ms95ir-ctrl/Abadi_Rover/abadi-rover-2/README.md

# Abadi Rover 2: the telepresence robot

A small round robot with a screen and a camera. You stay in Germany, open a link on your phone, talk to your sister through the robot, and drive it around her home. Your sister can also call you with one big button.

**Status: first design draft (5 November 2026). Nothing is built and nothing is tested yet.** Every number comes from files, web sources or calculation. Each document marks what is VERIFIED (seen in a source) and what is ASSUMED (my guess, to be tested).

This folder is separate from **Abadi Rover 1** (the tracked robot with the Raspberry Pi 5, files at the top of the repository: `plan.md`, `wiring.md`, `HANDOVER.md`). Robot 1 is still in progress and nothing here changes it. Both robots use the same motherboard from `../pcb/kicad/` (version v5, the locked pin table is `../pcb/kicad/pin-table.md`).

---

## The robot in one picture

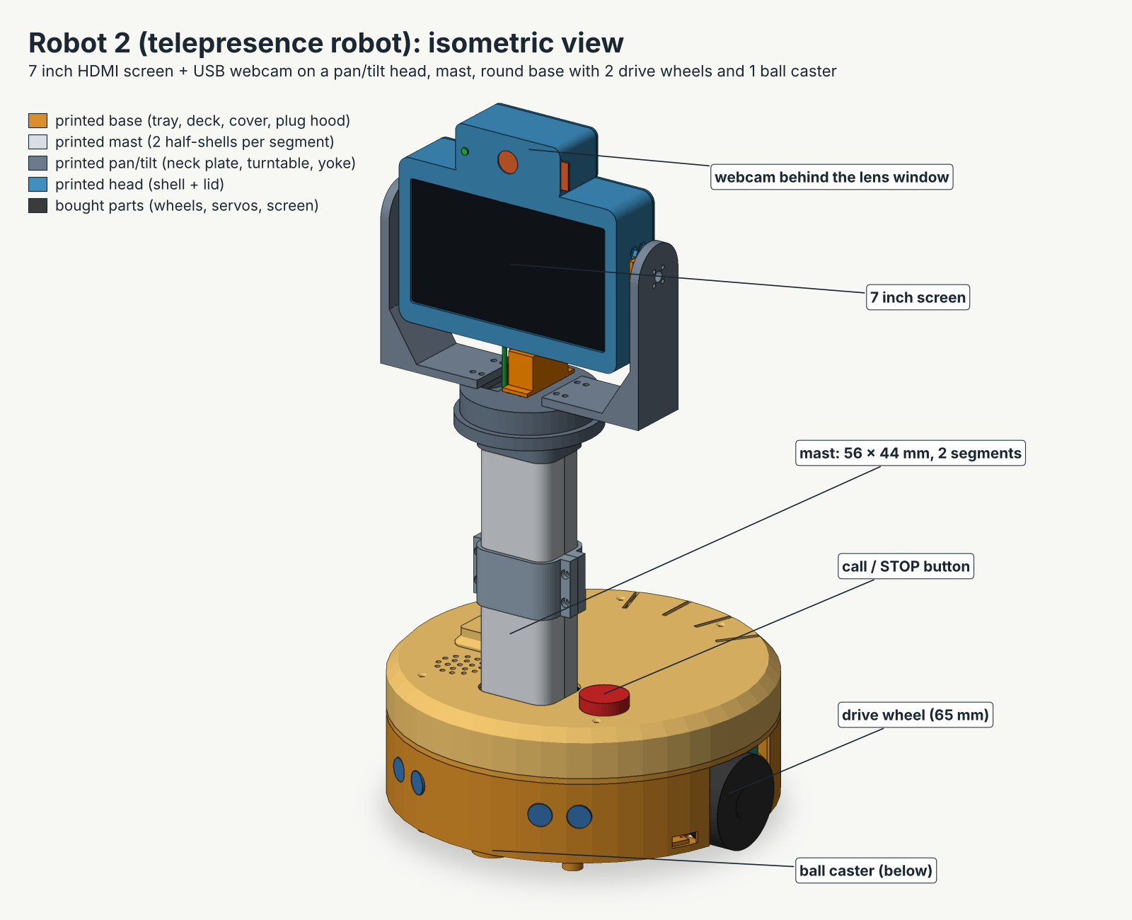
[picture p1: abadi-rover-2/3d/renders/robot2-iso.png]
Robot 2, isometric view


- **Body:** a round printed base, 260 mm wide, with two 65 mm drive wheels and one ball caster. A 214 mm mast carries the head. Total height 504 mm. Weight about 2.6 kg by the CAD (cheap build, first estimate); the parts list adds up to about 2.8 kg because it weighs every pack and cable in full.
- **Head:** a 7 inch HDMI screen with the webcam above it, on a pan and tilt fork (two MG996R servos).
- **Brain, two parts:** a **Raspberry Pi 5** does the video call and the internet link; the **ESP32 on the motherboard** drives the motors, servos and sensors and stops everything if the Pi stops talking. The Pi and the ESP32 talk over one USB cable.
- **Power:** the 2S Li-ion pack, BMS, charger and fused branches as in `../pcb/kicad/power-wiring.png`. A second XL4016 module set to 5.1 V feeds the Pi and the screen.

Wiring diagram: `diagrams/wiring-robot2.png`.

---

## Documents (read in this order)

| File | What it answers |
|---|---|
| `docs/functions.md` | **What can the robot do?** The function list, in plain words. |
| `docs/wiring.md` | **How is it wired?** The final wiring table, the decisions, the power-up order. |
| `diagrams/wiring-robot2.png` / `.svg` | The wiring diagram (source: `diagrams/draw_wiring.py`). |
| `diagrams/battery-4cell.png` / `.svg` | The optional 4-cell battery wiring (2S2P). The 2-cell battery diagram is `../pcb/kicad/battery-wiring.png`. |
| `docs/parts-list.md` and `docs/parts-list.csv` | **What do I buy, and what does it cost?** Two builds (cheap and comfortable), what to buy in Germany before the trip, weights, luggage rules. |
| `docs/sbc-selection.md` | **Which small computer?** Raspberry Pi 5 recommended; why the Radxa Cubie A7S and Orange Pi Zero 2W are not recommended. |
| `docs/mechanical-design.md` + `3d/` | **The body:** base, mast, head, pan/tilt interface, weights, tip-over test, print list. OpenSCAD files (`3d/*.scad`), print-ready STL files (`3d/stl/`), pictures (`3d/renders/`). |
| `docs/peripherals.md` | **Screen, camera, sound, sensors, battery monitor.** Includes the camera test for your SC-012-SN259 and the echo test. |
| `docs/software-plan.md` | **What has to be coded, and in which order.** Video call, remote access, family screen, Wi-Fi in a new place, ESP32 firmware plan, 10 build stages with pass tests, risks. |
| `docs/esp32-serial-protocol.md` | **The USB language between the Pi and the ESP32** (commands, messages, fault codes, stopping rules). |
| `docs/review-log.md` | What the independent review found, what was changed, and the points that are still open. |
| `docs/00-brief.md` | The brief the helper agents worked from (your request and the fixed facts). |

---

## The decisions so far

| Question | Decision | Where |
|---|---|---|
| Which small computer? | **Raspberry Pi 5, 2 GB** (or the Pi 5 8 GB you already own, if robot 1 can wait). Cheapest that really works: Pi 4 2 GB. **Not** the Radxa Cubie A7S (no HDMI port, immature software) or the Orange Pi Zero 2W. | `docs/sbc-selection.md` |
| Video call, first version | **Public Jitsi Meet in the robot's browser**, joining a one-time room. You are always the host. Version 2: one own web page. | `docs/software-plan.md`, section 3 |
| Reaching the robot from Germany | **Tailscale** (free private link; no router change at your sister's home). | section 4 |
| What stops the robot if the link drops | Four independent timers (250 ms, 300 ms, 500 ms, 1000 ms); it stops in about 0.4 s, or about 0.6 s if the ESP32 program hangs (both ASSUMED until measured). | section 4 and the protocol file |
| Chassis | A **new printed two-wheel base**, not the ELEGOO tracks (robot 1 needs those). | `docs/mechanical-design.md` |
| Motors | **Pololu 25D 12 V gearmotor, 47:1, two.** The yellow TT motors are too weak. | same |
| Screen | 7 inch HDMI touch screen (Waveshare (C) about 58 EUR, or a no-name one about 45 EUR). | `docs/peripherals.md` |
| Camera | Test your **SC-012-SN259** first (it could not be found online). Fallback: a cheap wide-angle 1080p webcam, about 22 EUR. | same |
| Pan/tilt | My default (two MG996R servos in a fork), **with a swappable plate** (INTERFACE 1) for your own design. | `docs/mechanical-design.md`, section 7 |
| Money | Cheap build about **582 EUR** if everything is bought new (417 EUR with spares from your drawer; 366 EUR if robot 1 lends parts). Comfortable build about **821 EUR** (614 / 487 EUR). The totals leave out a bench power supply (borrow one if you can) and the optional parts. | `docs/parts-list.md` |

---

## Build order (one stage at a time, one pass test each)

The software plan has the full pass tests. **Before the trip** these must be finished: stages 1 to 5, 7 and 9, **plus the safety part of stage 8** (stair-edge sensors, tilt and pick-up detection, family STOP). Stage 6 (pan and tilt) is strongly recommended. Rule: remote driving stays switched off in the software until the stair-edge and tilt tests pass. The first drives at your sister's home are with her standing next to the robot, away from stairs.

0. **Today, before any stage:** order the Pololu motors (they can take 2 to 3 weeks from the USA) and the screen; check that the boards you ordered are version v5; do the 10 minute camera test. Start printing the base parts (about 43 hours for the whole first build) only after you have checked every size marked (A) with the real parts (button, speaker, servo plugs, LED, webcam: `docs/mechanical-design.md`, section 11, step 1). Print `head_shell`, the lid, the yoke and the turntable only after the real screen, webcam and servos have arrived and been measured (make a paper template of the screen first). The mechanical assembly (`docs/mechanical-design.md`, section 11) and the first power-up (`docs/wiring.md`, section 4) run together: power-up steps 1 and 2 come before the deck goes on; steps 3 to 6 belong to stages 3 to 6 and are done with the cover still off (assembly step 7). Close the cover (assembly step 9) only after stages 3 to 5 and the servo check (power-up step 5) have passed.
1. Bench call: Pi, screen, webcam and audio only. Measures whether the Pi copes with the call.
2. The robot service: idle screen, call button, auto-start.
3. Power: the Pi and screen on the robot's own supply.
4. ESP32 link over USB (with the two cable bench tests), battery monitor, low-battery warning and clean shutdown, no motors yet.
5. Drive (wheels in the air first). Stop-time tests. The service dead-man timer and tab-close handling are built here.
6. Pan and tilt.
7. Remote access from the internet, on mobile data.
8. Safety sensors: sonar, stair edges, tilt and pick-up (the stair-edge and tilt part is required before the trip).
9. Polish and field kit: new-Wi-Fi rehearsal, spare SD card, family card.
10. Version 2: one page with video and controls.

Rule: no code for a later stage until the current stage passed on the real hardware. **No application code exists yet**; this folder has only plans, specs, diagrams and 3D files.

---

## What I need from you

1. **Which country** is the trip to, and **how many days** until you leave? (Decides what can be bought there, delivery times, and whether services such as Tailscale and Jitsi are reachable.)
2. **Your 3D printer and its bed size** (the design needs at least 180 x 180 mm). Do you print before the trip and pack the parts?
3. **Your pan/tilt design:** a photo, STL or the numbers in `docs/mechanical-design.md` section 7.4.
4. **The webcam SC-012-SN259:** its size and a photo, or run the 10 minute test in `docs/peripherals.md`.
5. **Can robot 1 lend its Pi 5 8 GB** (and battery parts) for the trip?
6. **Charging while the robot is on:** the current power plan says charge with the robot off. For a robot that can be called, that needs a decision. See `docs/wiring.md`, section 6. My default for now: the family switches the robot on at agreed call times and charges it at night.
7. **2 cells or 4 cells?** Two cells give about 1.1 to 1.4 hours of calling (about 1 hour if the robot also drives). Four cells double that but weigh more and need the 2S2P wiring in `docs/wiring.md`. My default for the first build is 2 cells.
8. **Are the 5 boards you ordered version v5?** All pin numbers here assume v5 (`../pcb/kicad/pin-table.md`).
9. The open questions at the end of each document.

### How to type a command (the documents use this a lot)

A "terminal" is a window where you type one line and press Enter. On the Raspberry Pi: open the menu, choose *Accessories*, then *Terminal* (or press `Ctrl` + `Alt` + `T`). Type the line exactly as written (copy and paste works), then press Enter. `sudo` at the start means "do this as the administrator"; the Pi may ask for your password. `nano` is a small text editor in the terminal: save with `Ctrl` + `O` then Enter, leave with `Ctrl` + `X`. On Windows, "Command Prompt" or "PowerShell" is the same idea; the 3D file commands have a Windows form in `docs/mechanical-design.md`, section 12.

---

## Honest limits of this draft

- No part was built, measured or tested. The weight, tip-over and runtime numbers are calculations.
- No tested 720p Chromium video call was found for any small board, including the Raspberry Pi. The home test in `docs/sbc-selection.md` section 10 decides this.
- Prices come from web search results, not from shop pages (the shops could not be opened). Check the live price when you buy.
- The mass (about 2.6 kg by the CAD for the cheap build, about 3.0 kg for the comfortable build; the parts list adds up to about 2.8 and 3.3 kg) is higher than the 1.5 to 2 kg target of the first draft, and the robot tips with about 4.4 N of push at head height (a ramp of about 22 degrees tips it). A shorter mast, ballast and a software tilt guard are described in `docs/mechanical-design.md`, section 8.
- **Runtime is short.** On 2 cells the robot calls for only about 1.1 to 1.4 hours (about 1 hour if it also drives); 4 cells give about 2.2 to 2.8 hours (all ASSUMED, measured in stage 3). Charging while the robot is on is not decided yet.
- The pan cable path in the head is not proven: until the real cable bundle is tested in stage 6, the pan range is limited to +/-30 degrees in the software.
- The stair-edge sensors see an edge only a few centimetres before the robot is lost, so keep the robot away from stairs; nothing protects driving backwards (`docs/mechanical-design.md`, section 5.6).
- Li-ion cells and power banks go in **carry-on luggage only**.
- The 3D design now has a 30 mm hole for the call / STOP button, a speaker grille on the cover top, a 5 mm camera-light hole and a camera slide-cover slot in the head. Their sizes are ASSUMED (open item C5 in `docs/peripherals.md`): measure your real button, speaker, LED and webcam and compare with `3d/robot2_params.scad` before you print the large parts.
