ms95ir-ctrl/Abadi_Rover/pcb/kicad/reports/kicad-drc-report.txt

** Drc report for /tmp/claude-0/-home-user-Abadi-Rover/2e40e7c1-9ccc-529a-8cb9-c3782861ad82/scratchpad/kb/final6.kicad_pcb **
** Created on 2026-10-20 20:47:07 **

** Found 38 DRC violations **
[lib_footprint_issues]: The current configuration does not include the library 'abadi'.
    Local override; Severity: warning
    @(194.5000 mm, 136.1900 mm): Footprint TM1
[lib_footprint_issues]: The current configuration does not include the library 'abadi'.
    Local override; Severity: warning
    @(196.0000 mm, 146.0000 mm): Footprint H2
[lib_footprint_issues]: The current configuration does not include the library 'abadi'.
    Local override; Severity: warning
    @(105.5000 mm, 76.5000 mm): Footprint TL3
[lib_footprint_issues]: The current configuration does not include the library 'abadi'.
    Local override; Severity: warning
    @(177.7500 mm, 135.0000 mm): Footprint C1
[lib_footprint_issues]: The current configuration does not include the library 'abadi'.
    Local override; Severity: warning
    @(145.6200 mm, 89.0000 mm): Footprint RLY2H
[lib_footprint_issues]: The current configuration does not include the library 'abadi'.
    Local override; Severity: warning
    @(187.0000 mm, 141.7700 mm): Footprint C3
[lib_footprint_issues]: The current configuration does not include the library 'abadi'.
    Local override; Severity: warning
    @(173.2000 mm, 54.2000 mm): Footprint SPARE
[lib_footprint_issues]: The current configuration does not include the library 'abadi'.
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
    Local override; Severity: warning
    @(112.3000 mm, 128.9500 mm): Footprint PCA
[lib_footprint_issues]: The current configuration does not include the library 'abadi'.
    Local override; Severity: warning
    @(148.1600 mm, 93.4000 mm): Footprint UART
[lib_footprint_issues]: The current configuration does not include the library 'abadi'.
    Local override; Severity: warning
    @(164.1500 mm, 103.0000 mm): Footprint DRVB
[lib_footprint_issues]: The current configuration does not include the library 'abadi'.
    Local override; Severity: warning
    @(112.4000 mm, 87.1000 mm): Footprint GYRO
[lib_footprint_issues]: The current configuration does not include the library 'abadi'.
    Local override; Severity: warning
    @(166.8600 mm, 89.0000 mm): Footprint SON1
[lib_footprint_issues]: The current configuration does not include the library 'abadi'.
    Local override; Severity: warning
    @(186.5200 mm, 92.5000 mm): Footprint RD2b
[lib_footprint_issues]: The current configuration does not include the library 'abadi'.
    Local override; Severity: warning
    @(137.0000 mm, 54.2000 mm): Footprint SCR_L

** Found 0 unconnected pads **

** Found 0 Footprint errors **

** End of Report **
