ms95ir-ctrl/Abadi_Rover/abadi-rover-2/diagrams/battery-4cell.png

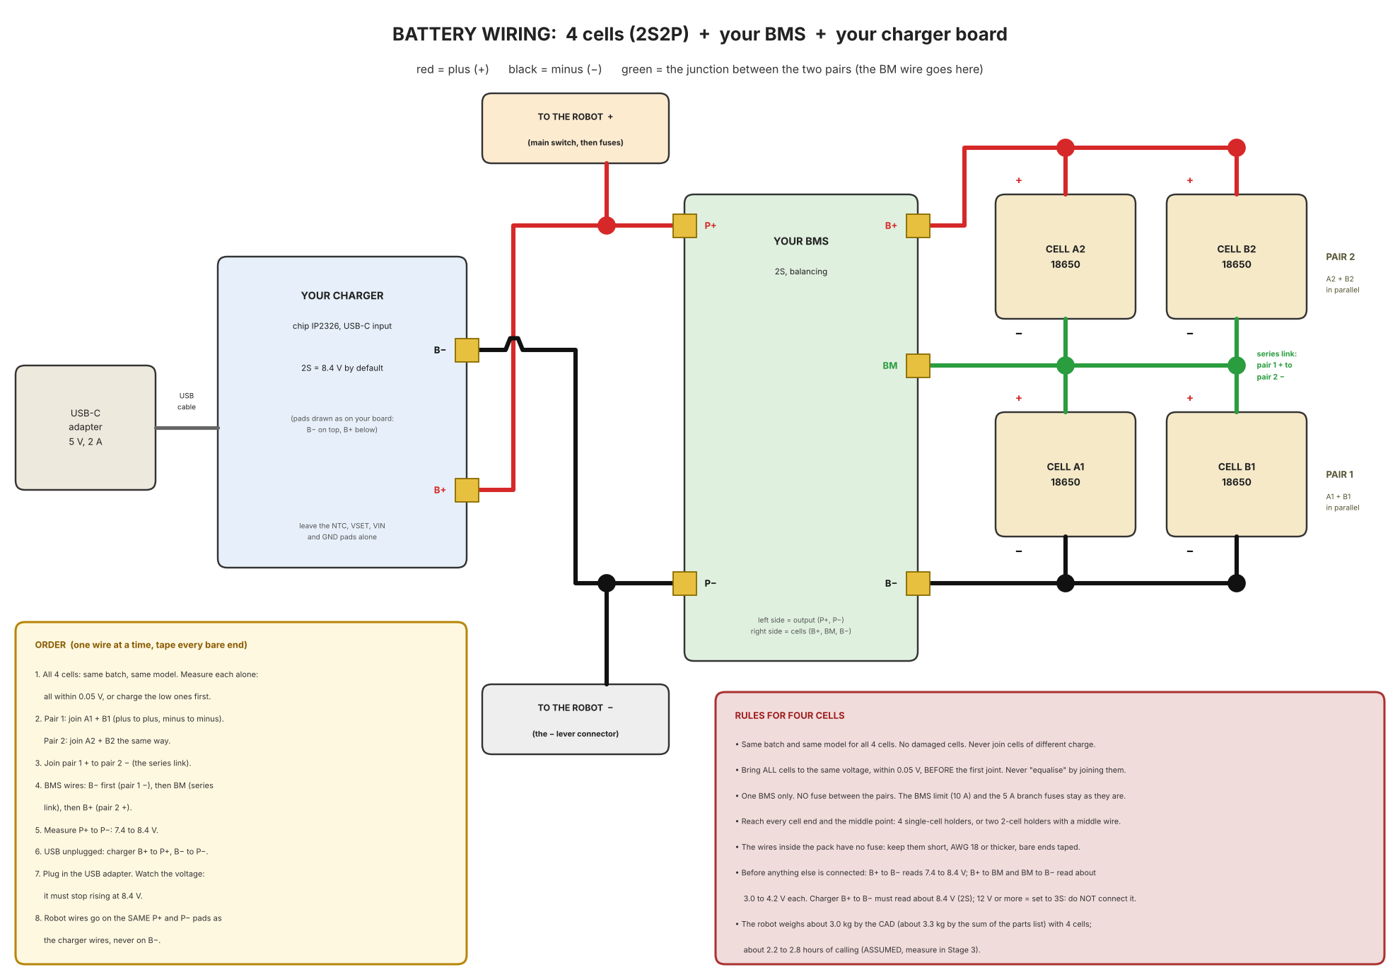
abadi-rover-2/diagrams/battery-4cell.png
