ms95ir-ctrl/Abadi_Rover/pcb/board-draft.png

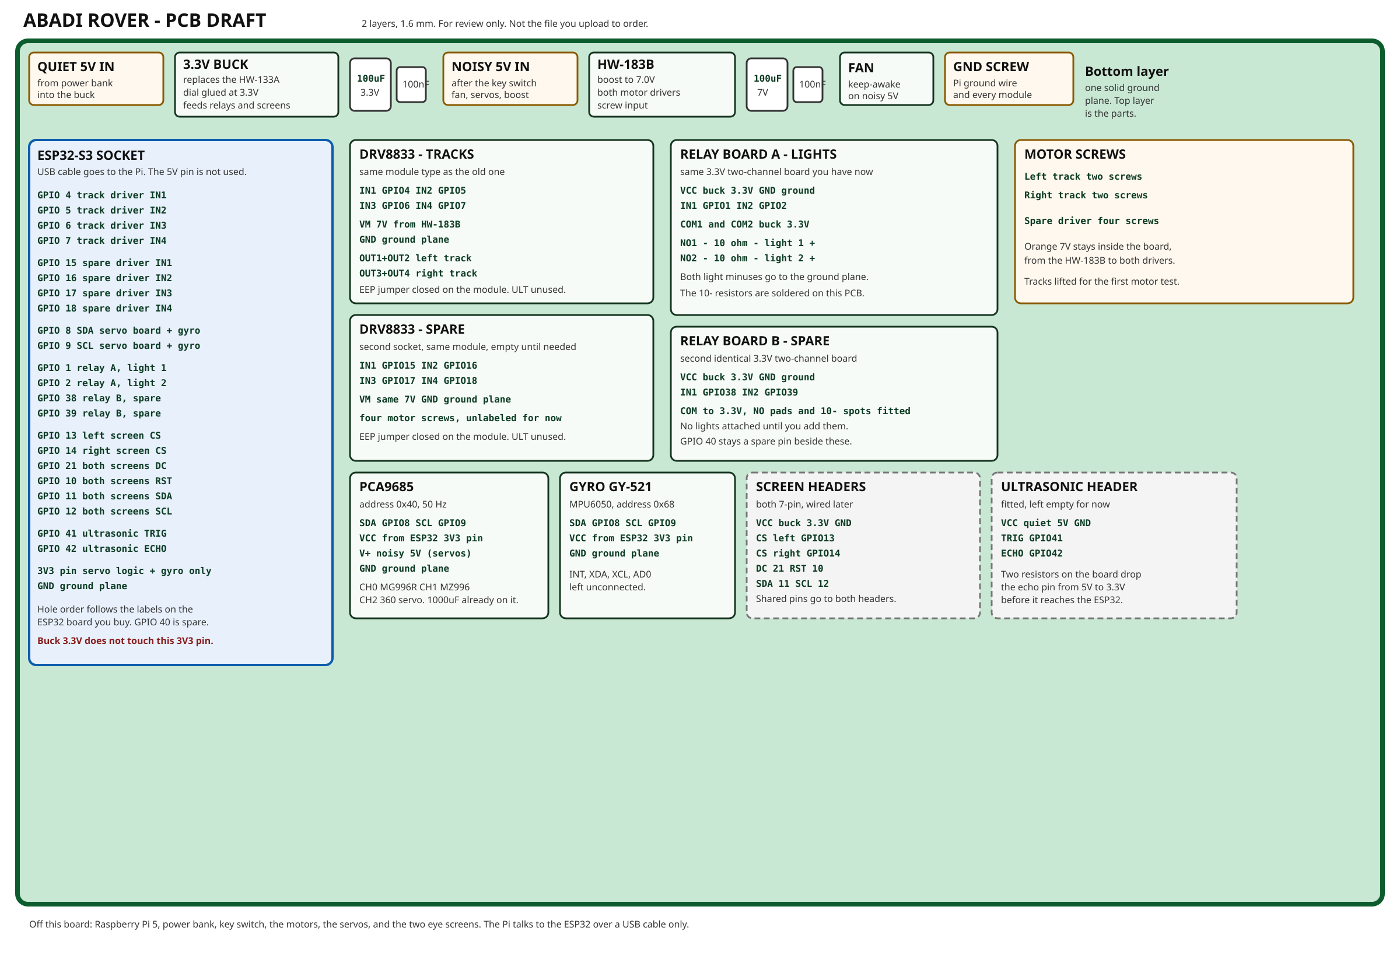
pcb/board-draft.png
