ms95ir-ctrl/Abadi_Rover/pcb/draft/floorplan_v0_3d.png

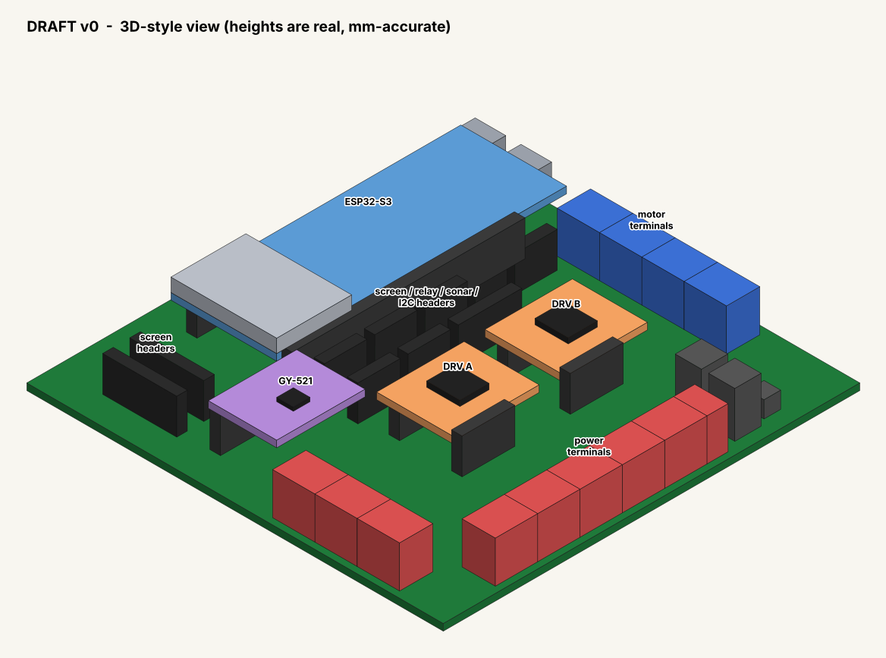
pcb/draft/floorplan_v0_3d.png
