ms95ir-ctrl/Abadi_Rover/pcb/draft/floorplan_v0_top.png

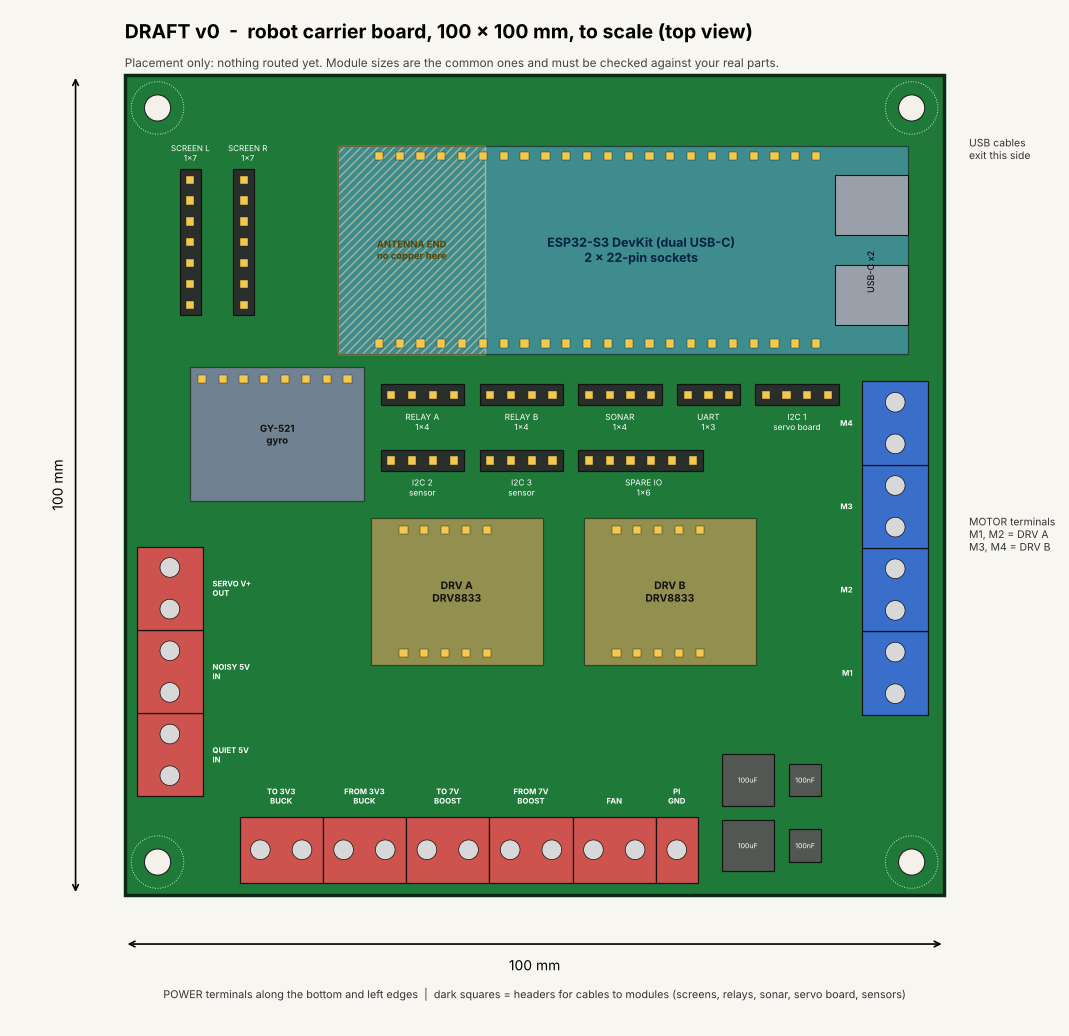
pcb/draft/floorplan_v0_top.png
