ms95ir-ctrl/Abadi_Rover/pcb/draft/floorplan_v1_top.png

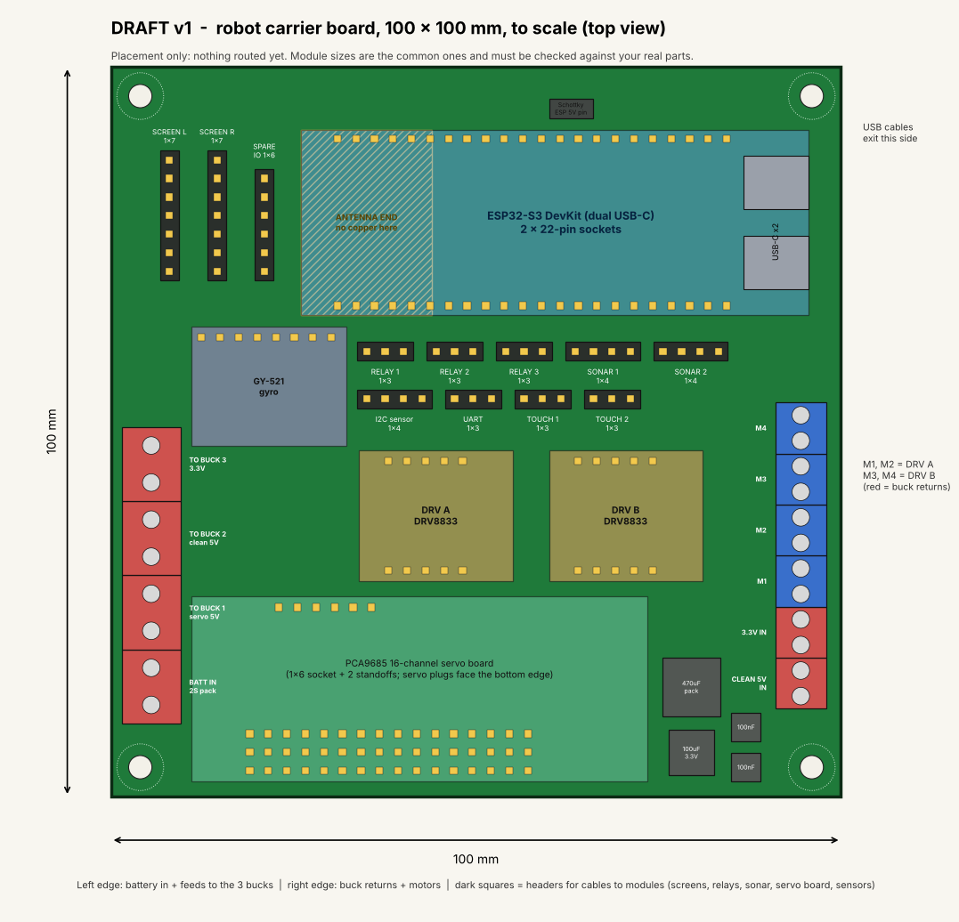
pcb/draft/floorplan_v1_top.png
