ms95ir-ctrl/Abadi_Rover/pcb/gerber-preview.png

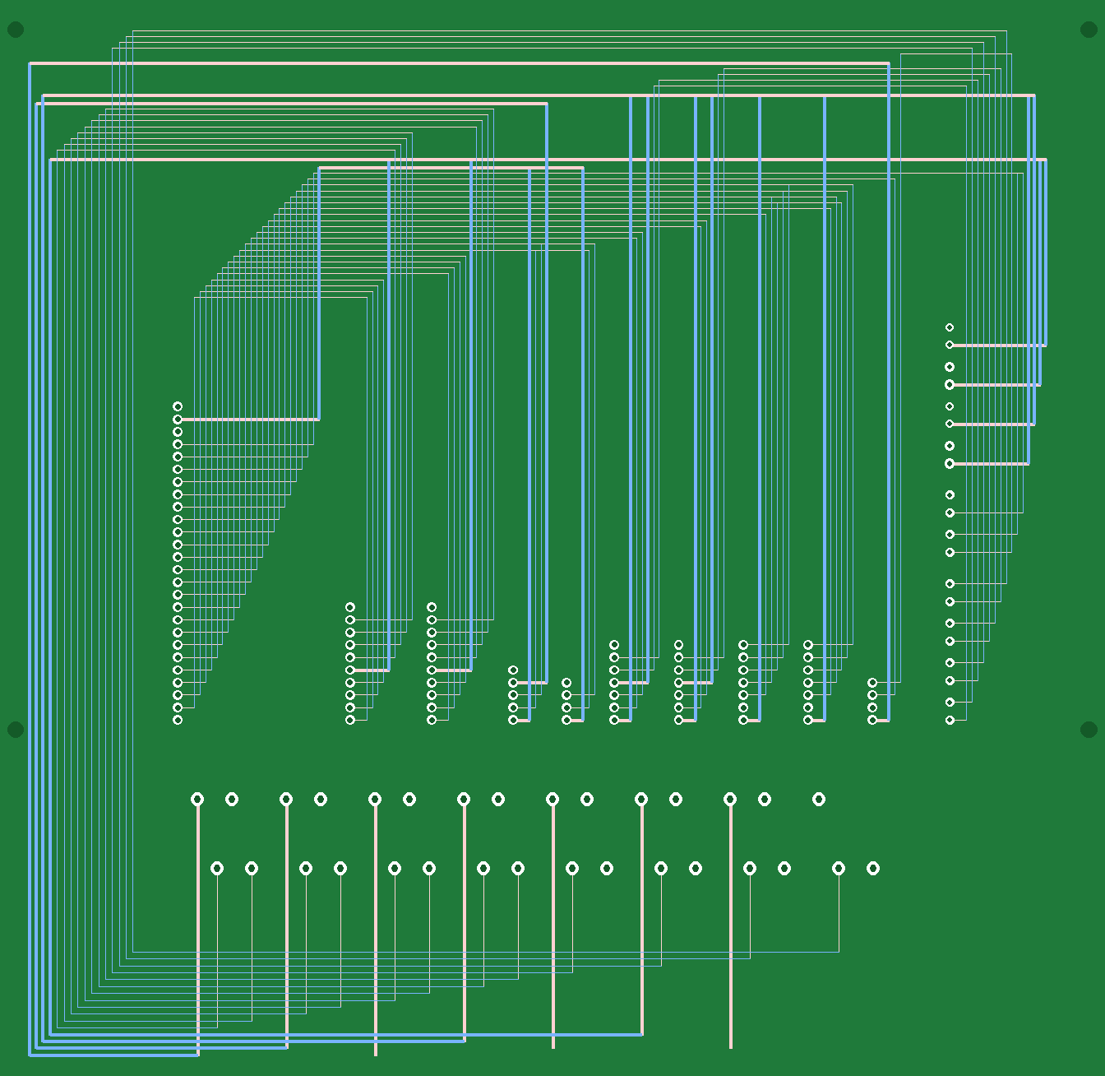
pcb/gerber-preview.png
