ms95ir-ctrl/Abadi_Rover/pcb/kicad/board-copper.png

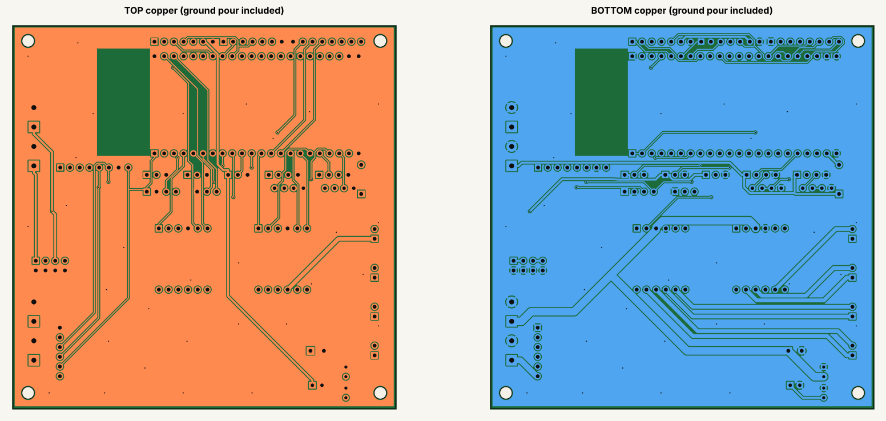
pcb/kicad/board-copper.png
