ms95ir-ctrl/Abadi_Rover/pcb/kicad/board-top.png

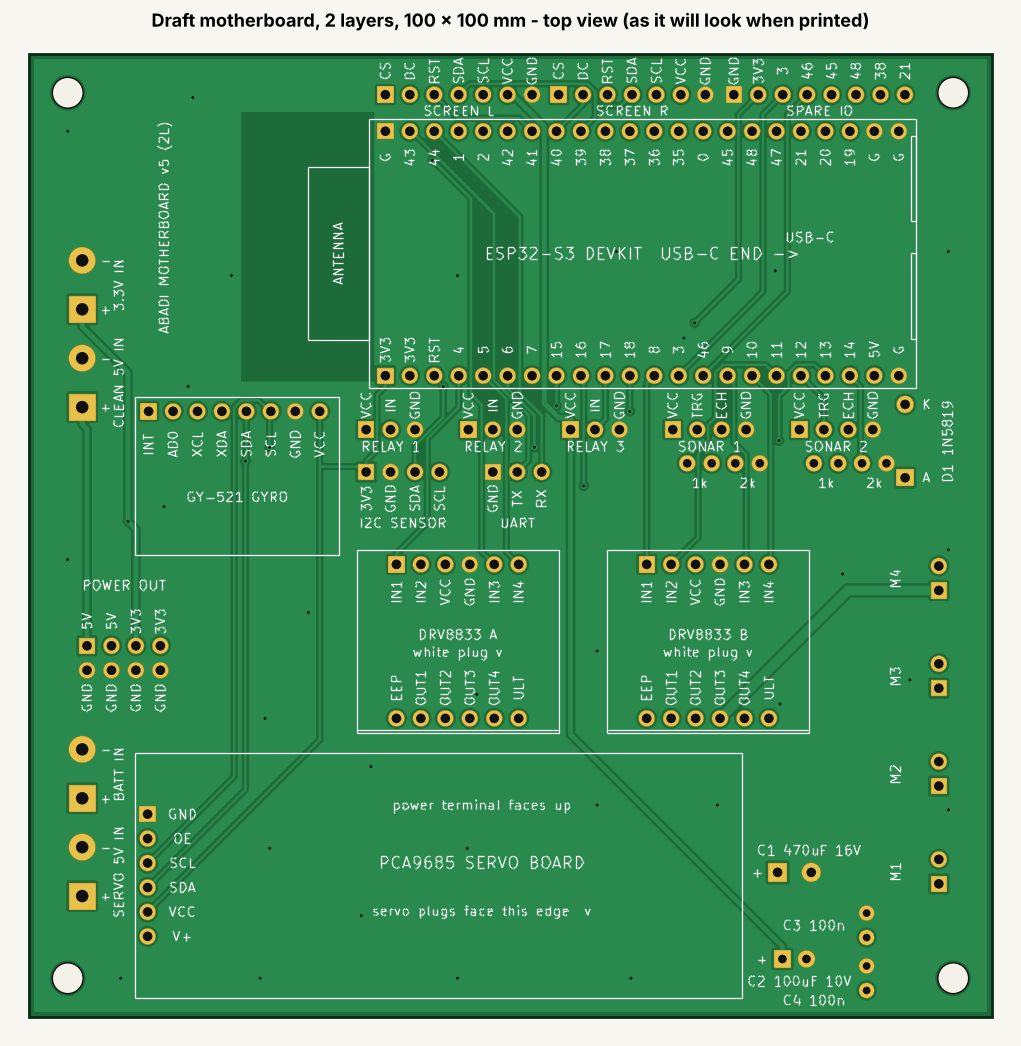
pcb/kicad/board-top.png
