ms95ir-ctrl/Abadi_Rover/pcb/layout.png

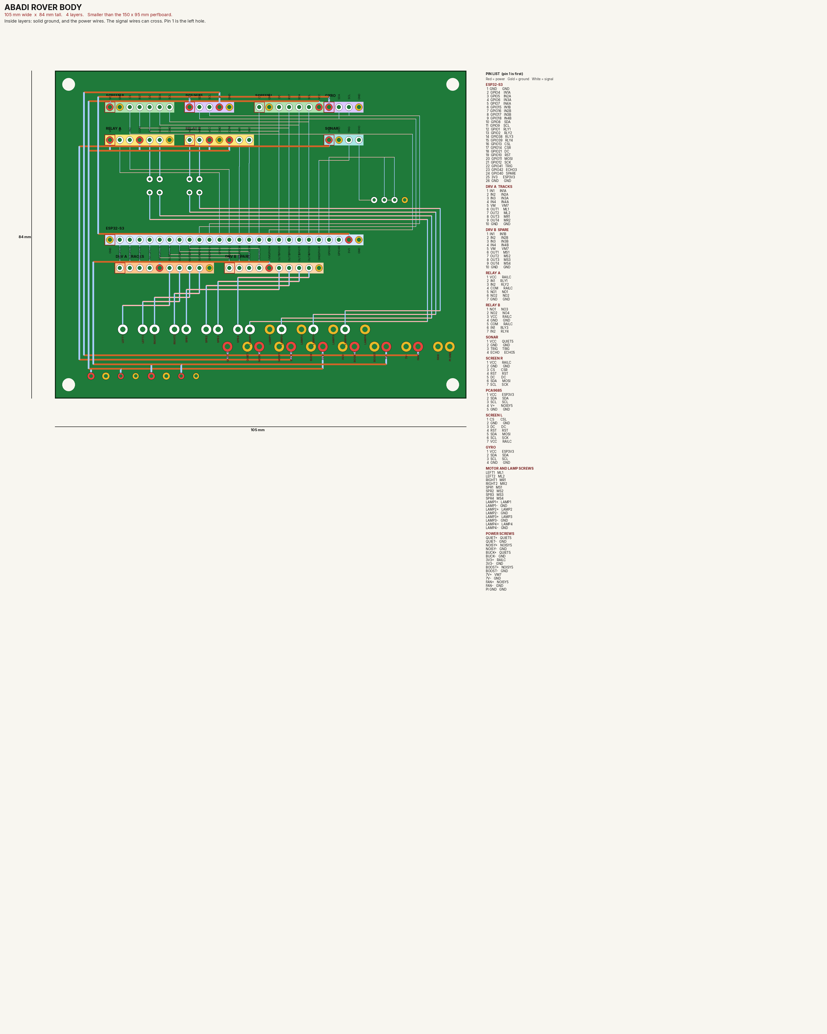
pcb/layout.png
