ms95ir-ctrl/Abadi_Rover/abadi-rover-2/3d/tools/parts.txt

tray_FL
tray_FR
tray_RL
tray_RR
deck_FL
deck_FR
deck_RL
deck_RR
cover_FL
cover_FR
cover_RL
cover_RR
caster_cup
caster_ring
motor_cap
skid
plug_hood
bumper_R
bumper_C
bumper_L
mast_lo_front
mast_lo_back
mast_up_front
mast_up_back
collar_front
collar_back
foot_plate
neck_plate
turntable
yoke_servo_side
yoke_plain_side
head_shell
head_lid
pivot_bush
cam_cover
