ms95ir-ctrl/Abadi_Rover/abadi-rover-2/docs/parts-list.csv

group | item | quantity | unit_price_eur | total_eur | build | already_owned_maybe | buy_where | buy_before_trip | weight_g | on_robot | notes
1 Brain and screen | Raspberry Pi 4 Model B, 2 GB (the cheapest board that really works) | 1 | 72.00 | 72.00 | cheap | no | Berrybase, Reichelt, Welectron | DE | 46 | yes | About 71.90 EUR on 1 Oct 2026 (Notebookcheck). Runs near full load in a 720p call, so the first call is asked at 480p. Fan and performance mode needed (sbc-selection.md, section 3).
1 Brain and screen | Raspberry Pi 5, 2 GB (recommended board) | 1 | 82.50 | 82.50 | comfort | maybe-robot1 | Berrybase, Reichelt, Welectron | DE | 46 | yes | About 82.50 EUR (Notebookcheck, 1 Oct 2026). 4 GB costs about 115-150 EUR. Free option: take your own Pi 5 8 GB if robot 1 can wait.
1 Brain and screen | Raspberry Pi 5 Active Cooler (official) | 1 | 5.90 | 5.90 | comfort | no | Welectron (5.90 EUR incl. VAT, art. RP9-111480) | DE | 12 | yes | Pi 5 only. Fits under the cover (cooler 13.7 mm high).
1 Brain and screen | Heatsink plus small 5 V fan for the Pi 4 | 1 | 6.00 | 6.00 | cheap | maybe-robot1 | Amazon.de, Berrybase | DE | 20 | yes | You own a 5 V fan for robot 1; robot 2 needs its own. About price (ASSUMED).
1 Brain and screen | microSD card 32 GB, A1 or A2, SanDisk or Samsung (main card) | 1 | 9.00 | 9.00 | both | no | any shop | any | 1 | yes | About price (ASSUMED). Buy a known brand, not an unnamed one.
1 Brain and screen | microSD card 32 GB (clone = spare card) | 1 | 9.00 | 9.00 | both | no | any shop | any | 1 | no | Clone the finished card onto it (stage 9; the spare card is a pass test there). Packed in the luggage, not in the robot.
1 Brain and screen | 7 inch HDMI screen, 1024x600 IPS, touch: no-name type | 1 | 45.00 | 45.00 | cheap | no | eBay.de, Amazon.de | DE | 250 | yes | Listings 43-57 EUR (eBay.de search). Check outline about 165x100-107 mm, full-size HDMI, 5 V micro-USB. Weight varies.
1 Brain and screen | Waveshare 7 inch HDMI LCD (C), 1024x600 IPS, 5-point touch (recommended screen) | 1 | 58.00 | 58.00 | comfort | no | exp-tech.de, Eckstein, Welectron, elecena.pl, melopero.com | DE | 250 | yes | Seen 48-62 EUR incl. VAT depending on shop (exp-tech.de 44.95 EUR is without VAT, about 53.50 with VAT; search summaries, re-check the shop page). 164.9x107x8 mm, 5 V 500 mA (Waveshare wiki). Stock varies: order early.
1 Brain and screen | HDMI cable, micro-HDMI to HDMI-A, flat and slim, 0.8 m | 1 | 12.00 | 12.00 | both | no | Amazon.de, Reichelt | DE | 40 | yes | Needs about 0.65 m (mast route); sbc-selection.md now says the same. Right-angle plug at the screen end is better.
1 Brain and screen | Screen power lead: micro-USB plug with bare wires, power only | 1 | 3.00 | 3.00 | both | maybe-spare | any (cut an old micro-USB cable) | any | 15 | yes | Wires go to the 5.1 V SBC buck branch (not to the clean 5 V). Via the 1 A fuse.
1 Brain and screen | USB-C plug breakout board with solder pads, for the SBC power pigtail (you solder your own AWG 18-20 silicone wire to ALL the VBUS and GND pads) | 1 | 5.00 | 5.00 | both | no | Amazon.de, eBay.de | DE | 20 | yes | Or cut a thick 5 A USB-C cable and read the wire gauge printed on its jacket. If the wire is thinner than AWG 20, use a 3 A fuse on this branch (the fuse assortment in group 4 should have one: check the listing) and accept a Pi 5 peak limit; with a Pi 4 get thicker wire instead (sbc-selection.md, section 7, points 4 and 5). Short: under 40 cm. The wire is the silicone wire line in group 4. About price (ASSUMED).
1 Brain and screen | Capacitor 1000 uF, 16 V, low-ESR (at the SBC power input) | 1 | 0.60 | 0.60 | both | maybe-spare | Reichelt | any | 4 | yes | Across 5.1 V and GND at the Pi end. 470 uF also fine.
1 Brain and screen | USB-A to USB-C cable, short (20 cm), ordinary (has the 5 V wire), for the ESP32 COM socket | 1 | 4.00 | 4.00 | both | maybe-spare | any | any | 10 | yes | Plug it into the data-only adapter below. It is also the one spare ordinary cable: if bench test B fails (the two bench tests are written out in peripherals.md, 6.1), use it on its own. Taping the 5 V contact (pin 1 of the USB-A plug) is a backup only.
1 Brain and screen | USB data-only adapter (power blocker, no 5 V wire), for the ESP32 link and for touch | 2 | 5.00 | 10.00 | both | no | Amazon.de (search: USB power blocker / Stromsperre) | DE | 20 | yes | One for the ESP32 link, one for the touch cable. Not the same as a 'data blocker' (that blocks data). Check the ESP32 one with bench test A (the devkit's LED stays dark, peripherals.md, 6.1) and the touch one with the screen-dark check (peripherals.md, 2.2). About price (ASSUMED).
1 Brain and screen | Touch cable, micro-USB to USB-A, thin, about 1 m, data (the screen box may already contain one: check that it reaches the SBC through the mast, about 0.65 m plus slack) | 1 | 3.00 | 3.00 | both | maybe-spare | any (or the one from the screen box) | any | 15 | yes | It goes into the second data-only adapter. Keep it uncut: the screen power lead is a separate cable. About price (ASSUMED).
1 Brain and screen | USB-A right-angle adapter (90 degrees, male plug to female socket), for the webcam, the ESP32 link, the touch cable and the sound adapter or speakerphone | 4 | 2.50 | 10.00 | both | no | Amazon.de, eBay.de | DE | 24 | yes | The USB ports face the rear wall and only 20 to 42 mm of room is left (mechanical-design.md, 5.2), so straight plugs and the data-only adapters would press on the wall. Dry-fit with the real parts before you print the base. If the webcam gets the extension cable below, its adapter is a spare. About price (ASSUMED).
1 Brain and screen | USB-A extension cable, about 1 m, male right-angle plug to female socket (for a webcam whose cable is fixed to the camera) | 1 | 4.00 | 4.00 | both | no | Amazon.de, eBay.de | DE | 30 | yes | mechanical-design.md, 6.2: the camera's own plug joins it inside the head. Needed if the camera cable cannot be unplugged (most cannot). About price (ASSUMED).
2 Camera and audio | Webcam: your own SC-012-SN259, if it passes the test | 1 | 0.00 | 0.00 | cheap | maybe-robot1 | from robot 1 (phase 3 has not started) | DE | 60 | yes | Model not found on the web: size, view angle and microphone are ASSUMED. Test first (peripherals.md). Buy another for robot 1 later.
2 Camera and audio | Wide-angle USB webcam, 1080p, UVC, with microphone (fallback or comfort) | 1 | 22.00 | 22.00 | comfort | no | Amazon.de | DE | 70 | yes | About 15-30 EUR (ASSUMED). Check body fits the brow 60x30x28 mm and view angle 90-110 degrees.
2 Camera and audio | USB audio adapter (3.5 mm speaker out) | 1 | 7.00 | 7.00 | cheap | no | Amazon.de, eBay.de | any | 10 | yes | Cheap audio route B. Not needed with route A (speakerphone).
2 Camera and audio | Speaker 40 mm, 4 ohm, 3 W | 1 | 2.50 | 2.50 | cheap | no | Reichelt, eBay.de | any | 15 | yes | Goes in the cover top, right of the mast, facing up; not in the head lid (echo). The CAD has the grille and the pocket (mechanical-design.md, 7.1); the 15 mm depth is ASSUMED, measure yours.
2 Camera and audio | PAM8403 amplifier board, 5 V | 1 | 2.50 | 2.50 | cheap | no | eBay.de, AZ-Delivery | any | 3 | yes | Powered from the 5.1 V Pi-buck output through its OWN 1 A fuse (6th fuse holder, group 4), not through the screen fuse. Input from the USB audio adapter through the audio cable below.
2 Camera and audio | Audio cable, 3.5 mm plug to bare wires (or a cut aux cable), for the amplifier input | 1 | 1.50 | 1.50 | cheap | maybe-spare | any (cut an old aux cable) | any | 15 | yes | Route B only. Two wires (signal and ground) go to the amplifier input; the plug goes into the green socket of the USB audio adapter.
2 Camera and audio | USB speakerphone with real echo cancelling (Jabra Speak 410 class) | 1 | 75.00 | 75.00 | comfort | no | Amazon.de, Galaxus.de, eBay.de | DE | 350 | yes | Seen 60-85 EUR (eBay new 59.99, a shop 84.99 in Jun 2026). Cheaper ones (17-31 EUR) do not say 'echo cancellation': do not trust them. Weight and size ASSUMED. Doubles as ballast. The CAD has a flat spot of 115 mm diameter on the cover top, behind the mast (mechanical-design.md, 7.1).
2 Camera and audio | LEDs 5 mm red, 5 pieces, plus 220 ohm resistors | 1 | 2.00 | 2.00 | both | maybe-spare | Reichelt, any | any | 2 | yes | Plain red LEDs that light at 3.3 V. Camera-live LED on PCA9685 channel 2 (and button light on channel 3). If every PCA9685 output already has a 220 ohm resistor (small SMD parts marked 221), connect the LED with NO extra resistor and check the brightness.
2 Camera and audio | USB clip-on microphone (only if the webcam has no microphone) | 1 | 8.00 | 8.00 | opt | no | Amazon.de | any | 15 | yes | Only needed if the webcam test finds no microphone and you use route B.
3 Sensing | HC-SR04 ultrasonic sensor, 5 V type (not the 3.3 V HC-SR04P) | 2 | 2.00 | 4.00 | both | maybe-robot1 | AZ-Delivery, Berrybase, eBay.de | DE | 18 | yes | The board's 1k/2k divider expects a 5 V echo.
3 Sensing | HC-SR04 spare | 1 | 2.00 | 2.00 | comfort | no | AZ-Delivery, Berrybase, eBay.de | DE | 9 | no | Spare.
3 Sensing | IR floor sensor module, TCRT5000 type, digital output, 3.3-5 V (cliff) | 2 | 1.50 | 3.00 | both | no | eBay.de, Amazon.de | DE | 8 | yes | About 31x14 mm per mechanical doc (ASSUMED). Must work at 12 mm from the floor.
3 Sensing | IR floor sensor spares, to find a pair that reads your floor | 2 | 1.50 | 3.00 | both | no | eBay.de, Amazon.de | DE | 8 | no | Dark carpet can fool IR sensors. Buy 4 modules in both builds, test them on your floors and keep the best two (peripherals.md, 5.2): the cliff sensors are part of the required safety stage.
3 Sensing | ADS1115 16-bit analog-to-digital board (battery monitor) | 1 | 4.50 | 4.50 | both | no | eBay.de, AZ-Delivery, Reichelt | DE | 3 | yes | 3.5-5 EUR on eBay.de, up to about 13 EUR in local shops (software-plan listing check).
3 Sensing | ADS1115 spare | 1 | 4.50 | 4.50 | comfort | no | eBay.de, AZ-Delivery, Reichelt | DE | 3 | no | Spare.
3 Sensing | Resistor and capacitor kit: 47k x2, 27k x2 (1 %), 10k x4, 100 nF x4 | 1 | 5.00 | 5.00 | both | maybe-spare | Reichelt, any | any | 5 | yes | Battery divider 47k/27k + 100 nF (the 47k sits on the splice-plus wire, the 27k and 100 nF at the ADS1115). Charger sense 2 x 10k (optional). A 10k is also the bump-switch pull-down (optional).
3 Sensing | Call / STOP button, arcade type 30 mm (optionally with a 3.3 V LED ring) | 1 | 3.50 | 3.50 | both | no | Amazon.de, Reichelt | DE | 20 | yes | GPIO45 to GND. A physical STOP / call button is a Must before the trip (functions.md, rows 9 and 12), so it is in both builds. The CAD has a 30 mm hole on the cover top, left of the mast (mechanical-design.md, 7.1; size ASSUMED, measure your button). A button light must work at 3.3 V: not a 12 V arcade ring.
3 Sensing | Micro switch with lever (KW12-3 type), 2 pieces, bumper | 1 | 2.00 | 2.00 | opt | no | Amazon.de, eBay.de | any | 4 | yes | Optional, not in the first build. If fitted: switches between GPIO46 and 3V3, plus a 10k pull-DOWN from GPIO46 to GND (peripherals.md, 5.4). The protocol lists GPIO46 as 'optional bump input' (event ev btn id:bump).
4 Power | 18650 Li-ion cell, genuine Samsung 25R / LG MJ1 / Molicel P28A class | 2 | 6.00 | 12.00 | both | maybe-spare | Akkuman, Akkuteile.de, Nkon | DE | 92 | yes | Seen 3.99-10 EUR per cell. You own old cells: test them first and use a matched pair (same voltage within 0.05 V before joining). Carry-on only.
4 Power | 18650 cells, 2 more (the 4-cell option, 2S2P: double runtime) | 2 | 6.00 | 12.00 | comfort | maybe-spare | Akkuman, Akkuteile.de, Nkon | DE | 92 | yes | All four cells from the same batch and the same model, brought to the same voltage within 0.05 V before joining. Build 2P, then 2S, one BMS only: see wiring.md, section 'Four-cell option (2S2P)' and diagrams/battery-4cell.png. Needs a bigger battery cradle in the base (about 77 x 80 x 21 mm). The robot then weighs about 3.3 kg by the sum of this list (3.03 kg by the CAD).
4 Power | Battery holder for 2 x 18650 | 1 | 2.00 | 2.00 | both | no | Amazon.de, Reichelt | any | 14 | yes | 77x40x21 mm per mechanical doc. The BMS needs a wire at the point between the two cells (BM): use a 2-cell holder where you can reach that point, or two single-cell holders. 4-cell option: four single-cell holders in total, or two 2-cell holders whose middle point you can reach and join (next line).
4 Power | Battery holder, 2nd set for the 4-cell option (four single-cell holders in total, or two 2-cell holders whose middle point you can reach and join) | 1 | 2.00 | 2.00 | comfort | no | Amazon.de, Reichelt | any | 14 | yes | This line is one more 2-cell holder or two more single-cell holders (about 2 EUR either way, ASSUMED). A 2-cell holder that is wired in series inside has no middle wire and cannot make the pairs: check this when it arrives, and if there is no middle wire or tag, use single-cell holders. How to join them (2P, then 2S): wiring.md, section 7 'Four-cell option (2S2P)' and diagrams/battery-4cell.png.
4 Power | 2S BMS (HX-2S-JH20 type), balancing | 1 | 3.00 | 3.00 | both | maybe-robot1 | Amazon.de, eBay.de | DE | 8 | yes | Buy twice if robot 1 keeps its own. One BMS only, also with 4 cells.
4 Power | 2S USB-C charger board (IP2326 type, 5 V in, 8.4 V out) | 1 | 5.00 | 5.00 | both | maybe-robot1 | Amazon.de, eBay.de | DE | 6 | yes | Charge with the robot off (shopping list and wiring.md). See conflict C3 in peripherals.md.
4 Power | USB-C wall charger 5 V, at least 2 A (for the charger board) | 1 | 9.00 | 9.00 | both | maybe-spare | any (plug type of the destination) | any | 60 | no | Buy it where you stay if the plug differs.
4 Power | USB-A to USB-C charging cable, 1 m | 1 | 4.00 | 4.00 | both | maybe-spare | any | any | 25 | no
4 Power | Main switch, round rocker, 10 A or more, 19 mm hole | 1 | 2.50 | 2.50 | both | maybe-robot1 | Amazon.de, Reichelt | any | 10 | yes | You own a key switch for robot 1. This one is for the rear wall.
4 Power | In-line fuse holder for 5 x 20 mm fuses | 5 | 1.20 | 6.00 | both | no | Reichelt, Amazon.de | DE | 40 | yes | Five branches: BATT IN, servo buck, clean 5 V buck, SBC buck, screen. The 3.3 V buck is not used in robot 2.
4 Power | In-line fuse holder for 5 x 20 mm fuses, 6th holder (route B: own 1 A fuse for the speaker amplifier) | 1 | 1.20 | 1.20 | cheap | no | Reichelt, Amazon.de | DE | 8 | yes | Route B (cheap build) only. The amplifier gets its own tap from the 5.1 V Pi-buck output through its own 1 A fuse; the screen keeps its own 1 A fuse. With the speakerphone (route A) there is no amplifier and five holders are enough. The 1 A fuse comes from the assortment below.
4 Power | Slow-blow fuses 5 x 20 mm, assortment (1 A, 2 A, 3 A, 5 A) | 1 | 5.00 | 5.00 | both | no | Reichelt, Amazon.de | DE | 5 | yes | Needs: 5 A x3 (BATT IN, servo buck, Pi buck), 2 A x1 (clean 5 V buck), 1 A x2 (screen, and the amplifier in route B), plus spares. The 3 A is only for a Pi 5 with a pigtail wire thinner than AWG 20 (it replaces the 5 A on the Pi branch); with a Pi 4 get thicker wire (AWG 20 or thicker) and keep the 5 A. Check that the assortment you buy lists 3 A; if it does not, buy one single 3 A slow-blow only if you have a Pi 5 and your wire turns out to be thin. The optional 6.3 A slow-blow for the Pi branch is the next line.
4 Power | Slow-blow fuse 5 x 20 mm, 6.3 A (spare for the Pi branch, only if the 5 A fuse blows in rare peaks) | 2 | 0.30 | 0.60 | opt | no | Reichelt, Amazon.de | DE | 2 | no | Optional, not in the totals. Use it only with AWG 18 to 20 wire (peripherals.md, 6.2). About price (ASSUMED).
4 Power | Lever connector Wago 221-415 (5-way) | 4 | 1.20 | 4.80 | both | no | Berrybase, Reichelt, Hornbach | any | 36 | yes | Splice plus and splice minus: two connectors per side, each pair joined by a 10 cm jumper wire in a free slot of each. The plus side has 6 wires, the minus side up to 7. Budget 1.20 EUR each (ASSUMED): 2-way pieces were seen at 0.39 to 0.55 EUR, no 5-way price was seen.
4 Power | XL4016 buck module with heatsink (servo 5.0 V, and SBC 5.1 V) | 2 | 6.00 | 12.00 | both | maybe-robot1 | eBay.de 3-5 EUR, Amazon.de or AZ-Delivery 8-11 EUR | DE | 110 | yes | Two are needed. You own one for robot 1: buy two new. After setting each one with a multimeter, lock the adjust screw with a drop of glue or nail varnish.
4 Power | Fixed 5 V buck, 1.8 A (clean 5 V) | 1 | 2.50 | 2.50 | both | maybe-robot1 | eBay.de, Amazon.de | DE | 3 | yes | Input range must cover 6-8.4 V. After any luggage trip, re-measure all three buck outputs with nothing connected before you plug in the Pi or the ESP32.
4 Power | Silicone wire 1.0 mm2 (AWG 18), red and black, 3 m each | 1 | 7.00 | 7.00 | both | maybe-spare | Amazon.de, Reichelt | any | 40 | yes | Battery, buck and SBC branches, the 10 cm jumpers between the lever connectors, and the second servo feed to the PCA9685 screw terminal. Weight = what is used.
4 Power | Wire 0.5 mm2 and thinner, several colours | 1 | 8.00 | 8.00 | both | maybe-spare | Amazon.de, Reichelt | any | 20 | yes | Sensors, LED, screen power.
4 Power | JST-XH plug kit 2/3/4-pin with crimped wires | 1 | 9.00 | 9.00 | both | maybe-spare | Amazon.de | any | 15 | yes | Board headers are JST-XH / 2.54 mm. You said your plugs fit.
4 Power | Wire end ferrules, assortment | 1 | 5.00 | 5.00 | comfort | no | Amazon.de | any | 0 | no | For the screw terminals and lever connectors.
4 Power | Servo extension cable 50 cm, 3-wire | 3 | 2.00 | 6.00 | both | no | Amazon.de, eBay.de | DE | 36 | yes | Pan, tilt, and the camera LED up the mast. For the LED use a 3-pin plug with the red (V+) wire cut off or taped.
4 Power | Spade lugs (flat crimp terminals), 6.3 mm, small assortment, for the main switch | 1 | 3.00 | 3.00 | both | maybe-spare | Amazon.de, Reichelt | any | 2 | yes | The main switch has spade tabs (wiring.md, peripherals.md section 7). Check the tab width of your switch: 6.3 mm is common (ASSUMED). About price (ASSUMED).
4 Power | Single-cell 18650 charger (TP4056 type) | 1 | 3.00 | 3.00 | comfort | maybe-spare | Amazon.de, eBay.de | any | 25 | no | 4-cell option only: to bring the lower cells up to the same voltage (within 0.05 V) before they are joined (wiring.md, section 7, Four-cell option). Also handy for old cells. About price (ASSUMED).
4 Power | TVS diode SMBJ5.0A (optional protection across the Pi supply wires) | 1 | 0.50 | 0.50 | opt | no | Reichelt, eBay.de | any | 1 | no | Optional, not in the totals.
4 Power | 8.4 V 2 A charger adapter with DC jack (idea for charging while on) | 1 | 10.00 | 10.00 | opt | no | Amazon.de | DE | 120 | no | Only if the power design decides to charge while the robot runs. Not decided: conflict C3.
5 Drive | Pololu 25D metal gearmotor 12 V, medium power, 47:1 (item 3229) | 2 | 36.00 | 72.00 | both | no | Pololu.com, or an EU reseller (Eckstein, Botland) | DE | 182 | yes | Pololu US$29.95 each (search summary only, re-check the page). Plus shipping, 19 % VAT, maybe a courier fee: about 30-45 EUR each delivered (ASSUMED). 2-3 weeks. When they arrive, measure the winding resistance with a multimeter: about 6.7 ohm is expected (12 V / 1.8 A). If it reads well below 5 ohm, do not fit them to the DRV8833 (peripherals.md, section 8).
5 Drive | Robot wheels 65 mm, rubber tyre, hub for 4 mm D-shaft (pair) | 1 | 10.00 | 10.00 | both | no | Amazon.de, eBay.de, robot shops | DE | 60 | yes | Bore is ASSUMED to fit the Pololu 4 mm D-shaft: check before buying.
5 Drive | Hub adapters 4 mm D-shaft for wheels (only if the wheel bore does not fit) | 1 | 8.00 | 8.00 | comfort | no | Pololu, Amazon.de | DE | 20 | yes | Insurance.
5 Drive | Steel ball 16 mm (or 5/8 inch) for the caster | 1 | 1.50 | 1.50 | both | no | hardware store, Amazon.de | any | 17 | yes
5 Drive | Steel ball 16 mm, spare | 1 | 1.50 | 1.50 | comfort | no | hardware store, Amazon.de | any | 17 | no
6 Pan/tilt | MG996R servo, metal gear (pan and tilt) | 2 | 8.00 | 16.00 | both | maybe-robot1 | Amazon.de, eBay.de (4.50-7 EUR), Waveshare 13 EUR | DE | 110 | yes | PCA9685 channel 0 = pan, channel 1 = tilt. Buy twice if robot 1 keeps its servos.
6 Pan/tilt | Aluminium servo horn 25T, 20 mm disc, 4 x M3 holes | 2 | 3.50 | 7.00 | both | no | Amazon.de, AliExpress | DE | 16 | yes | Hard to find locally. The kit's plastic horn is not used.
6 Pan/tilt | MG996R spare | 1 | 8.00 | 8.00 | comfort | no | Amazon.de, eBay.de | DE | 55 | no | Spare.
7 Mechanical hardware | Heat-set insert assortment M2-M5, brass | 1 | 11.00 | 11.00 | both | no | Amazon.de | DE | 15 | yes | Needs 37 x M3 and 8 x M4 (plus 20 % spare). Mechanical doc, section 10.
7 Mechanical hardware | Screw and nut assortment M2.5/M3/M4/M5 hex socket, 6-30 mm | 1 | 16.00 | 16.00 | both | maybe-spare | Amazon.de, Reichelt | any | 70 | yes | Counts in mechanical doc section 10: about 64 x M3, 12 x M4, 4 x M2.5. The 4 motherboard screws are M3 x 6.
7 Mechanical hardware | M5 x 30 bolt with lock nut and 2 washers | 1 | 1.00 | 1.00 | both | maybe-spare | any | any | 10 | yes | Head pivot.
7 Mechanical hardware | PTFE adhesive tape 0.2 mm (turntable glide ring) | 1 | 6.00 | 6.00 | both | no | Amazon.de | DE | 2 | yes | About price (ASSUMED).
7 Mechanical hardware | PETG filament 1 kg spool, 1.75 mm (printed parts weigh about 1.13 kg) | 2 | 13.00 | 26.00 | both | no | Amazon.de, eBay.de | any | 1125 | yes | Seen 9.75-13.45 EUR per kg (deals Jun 2026). Weight = printed parts of the first build without the bumper (3d/tools/results/numbers.txt). Buy the filament first, so that printing can start: it takes about 43 hours (44.6 with the optional bumper), a rough figure (A). No tube needed: the mast is printed.
7 Mechanical hardware | Super glue plus 2-part epoxy | 1 | 6.00 | 6.00 | both | maybe-spare | any | any | 15 | yes | Base seams. The glue also locks the adjust screws of the two XL4016 buck modules once they are set, and a dab of nail varnish or marker pen across each screw and its module makes the position mark (if the line breaks, the screw has turned). No new part to buy.
7 Mechanical hardware | Double-sided foam mounting tape | 1 | 4.00 | 4.00 | both | maybe-spare | any | any | 10 | yes | Modules, screen, webcam.
7 Mechanical hardware | Zip ties 2.5 x 100 mm, 100 pieces | 1 | 3.00 | 3.00 | both | maybe-spare | any | any | 15 | yes | About 25 needed.
7 Mechanical hardware | Self-adhesive cable tie mounts, 10 pieces (2 to 4 needed) | 1 | 2.00 | 2.00 | both | maybe-spare | any | any | 3 | yes | One low in the mast or on the deck, one in the head (mechanical-design.md, 6.3). About price (ASSUMED).
7 Mechanical hardware | Foam pads 3 mm and Kapton tape | 1 | 3.00 | 3.00 | both | maybe-spare | any | any | 5 | yes | Screen retention. The Kapton tape is the backup for the USB 5 V contact (pin 1 of the USB-A plug).
8 Motherboard fit-out | Motherboard v5 bare PCB (5 pieces; order only after the paper test-fit passes, see pcb/kicad/README.md) | 1 | 0.00 | 0.00 | both | maybe-board | JLCPCB (confirm the order status) | DE | 33 | yes | Bare board. You report 5 boards ordered: confirm they are version v5 (pcb/kicad/pin-table.md). If they are not v5, the pin numbers in these files do not apply.
8 Motherboard fit-out | ESP32-S3 DevKitC-1, N16R8, dual USB-C, headers soldered | 1 | 12.00 | 12.00 | both | maybe-board | Amazon.de, AZ-Delivery, AliExpress | DE | 10 | yes | About price (ASSUMED). Check it has two USB-C sockets.
8 Motherboard fit-out | DRV8833 motor driver module HW-627 (driver A only) | 1 | 2.50 | 2.50 | both | maybe-board | Amazon.de, eBay.de | DE | 3 | yes | Robot 2 uses M1 and M2 only, so driver B can stay empty.
8 Motherboard fit-out | DRV8833 HW-627 spare | 1 | 2.50 | 2.50 | comfort | no | Amazon.de, eBay.de | DE | 3 | no | Spare.
8 Motherboard fit-out | PCA9685 16-channel servo driver board | 1 | 6.00 | 6.00 | both | maybe-board | Amazon.de, AZ-Delivery | DE | 12 | yes | Check that it has its own V+ screw terminal: a second AWG 18 feed from the servo buck goes there (peripherals.md, 5.5).
8 Motherboard fit-out | GY-521 gyro board (MPU-6050) | 1 | 3.50 | 3.50 | both | maybe-board | Amazon.de, AZ-Delivery | DE | 3 | yes
8 Motherboard fit-out | Sockets, headers and 5.08 mm screw terminals for the board | 1 | 9.00 | 9.00 | both | maybe-board | Reichelt, AZ-Delivery | DE | 15 | yes | Full list in pcb/kicad/parts-list.md. Robot 2 fits 3 of the 4 terminals (not 3.3V IN).
8 Motherboard fit-out | Capacitors 470 uF and 100 uF, 2 x 100 nF, 1N5819 diode, 4 resistors 1k/2k | 1 | 3.00 | 3.00 | both | maybe-board | Reichelt | any | 5 | yes
9 Tools and consumables | Heat-shrink tubing assortment | 1 | 6.00 | 6.00 | both | maybe-spare | any | any | 3 | yes
9 Tools and consumables | Solder 1 mm, 100 g | 1 | 7.00 | 7.00 | both | maybe-spare | any | any | 100 | no | Tool: you probably own an iron and a multimeter.
9 Tools and consumables | Digital caliper | 1 | 12.00 | 12.00 | comfort | no | Amazon.de | DE | 120 | no | To check servo, webcam and screen sizes before printing. Weight is a guess (A).
9 Tools and consumables | Precision screwdriver and hex key set | 1 | 10.00 | 10.00 | comfort | maybe-spare | any | any | 150 | no | Weight is a guess (A).
9 Tools and consumables | Wire stripper and flush cutter | 1 | 10.00 | 10.00 | comfort | maybe-spare | any | any | 200 | no | Weight is a guess (A).
9 Tools and consumables | USB-C power meter (voltage and current) | 1 | 10.00 | 10.00 | comfort | no | Amazon.de | DE | 25 | no | Handy for the power tests in stage 3, and needed for the fallback of bench test B (peripherals.md, 6.1). Get an in-line meter with a USB-C plug on one side and a USB-C socket on the other (or two sockets and a short USB-C to USB-C cable). It goes between the ordinary cable's USB-C end and the devkit's COM socket, not at the Pi (the Pi's port is USB-A, so it does not fit there). Comfortable build: in the list. Cheap build: not in the total. Do bench test B at home first; only if it fails, buy one (about 10 EUR) or borrow one before the trip. Weight is a guess (A).
9 Tools and consumables | Servo tester | 1 | 3.00 | 3.00 | opt | no | Amazon.de, eBay.de | any | 20 | no | Only for the pan-servo bench test in mechanical-design.md (assembly step 10: power the servo from a tester and check that the turntable turns freely). Optional, not in the totals. About price (ASSUMED).
9 Tools and consumables | Adjustable bench power supply, 0 to 15 V or more, at least 3 A (5 A is better), with a volt display and a current limit | 1 | 40.00 | 40.00 | opt | maybe-spare | borrow one, or Amazon.de | any | 1500 | no | Needed for the tests before the trip: the Pi under load with the pack voltage at 6.4 V and at 6.0 V (wiring.md, step 4) and the low-battery test at 6.7 V and 6.3 V (software-plan.md, Stage 4, pass 9). Borrow one if you can. The price is a guess (ASSUMED): simple adjustable ones with 3 A cost about 25 to 35 EUR, 5 A ones about 40 to 60 EUR. In no total.
10 Travel and spares | Spare ESP32-S3 DevKitC-1 | 1 | 12.00 | 12.00 | comfort | no | Amazon.de, AZ-Delivery | DE | 10 | no
10 Travel and spares | LAN cable 2 m (Wi-Fi plan D) | 1 | 3.00 | 3.00 | both | no | any | any | 60 | no | Stage 9 rehearses Wi-Fi plan D (software-plan.md).
10 Travel and spares | Small USB keyboard (Wi-Fi plan E) | 1 | 10.00 | 10.00 | both | maybe-spare | any | any | 300 | no | Stage 9 tries Wi-Fi plan E once (software-plan.md).
10 Travel and spares | Travel plug adapter | 1 | 8.00 | 8.00 | comfort | no | any | any | 60 | no | Country not known yet.
10 Travel and spares | Spare USB cables (USB-A to USB-C, ordinary, with data and 5 V) | 2 | 4.00 | 8.00 | comfort | maybe-spare | any | any | 20 | no
10 Travel and spares | Laminating pouches for the family card | 1 | 2.00 | 2.00 | both | no | any | any | 5 | no | For the family card (stage 9).
10 Travel and spares | Hard box or organiser for the trip (about 30 x 25 x 20 cm) | 1 | 15.00 | 15.00 | comfort | no | any | any | 400 | no | Printed parts stack into this size.
