ms95ir-ctrl/Abadi_Rover/abadi-rover-2/3d/stl/yoke_plain_side.stl

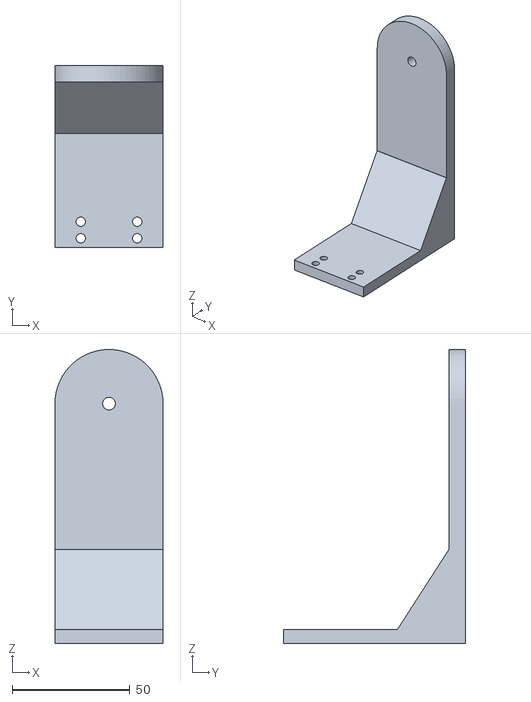
[picture p20: CAD file, 2026-11-05]
abadi-rover-2/3d/stl/yoke_plain_side.stl
46.0 x 77.5 x 125.0
