ms95ir-ctrl/Abadi_Rover/abadi-rover-2/3d/stl/motor_cap.stl

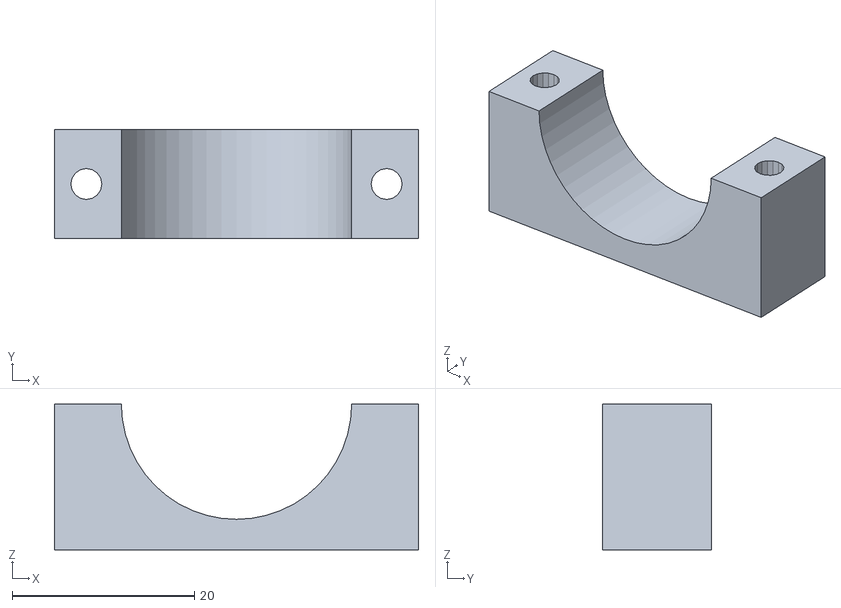
[picture p21: CAD file, 2026-11-05]
abadi-rover-2/3d/stl/motor_cap.stl
40.0 x 12.0 x 16.0
