ms95ir-ctrl/Abadi_Rover/abadi-rover-2/3d/stl/bumper_R.stl

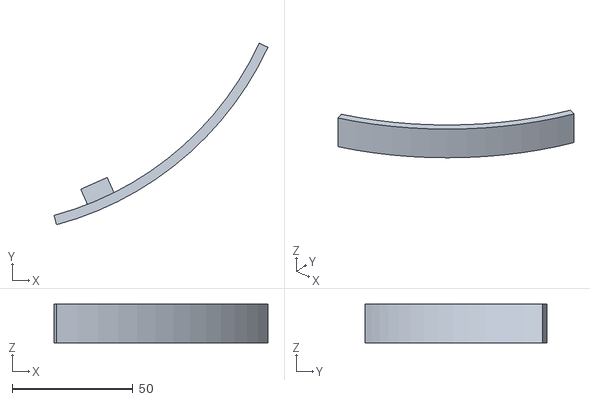
[picture p22: CAD file, 2026-11-05]
abadi-rover-2/3d/stl/bumper_R.stl
88.4 x 75.0 x 16.0
