ms95ir-ctrl/Abadi_Rover/abadi-rover-2/3d/stl/mast_lo_front.stl

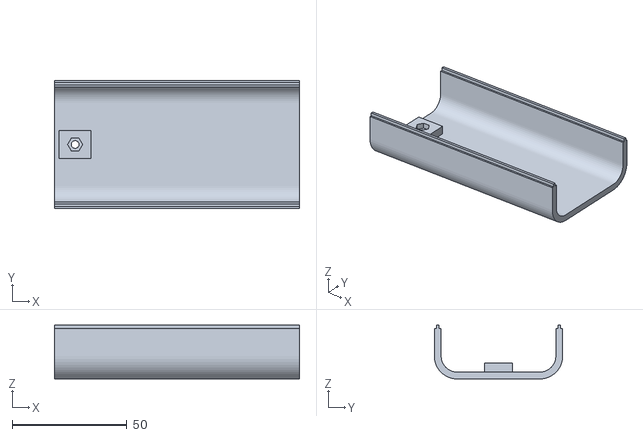
[picture p23: CAD file, 2026-11-05]
abadi-rover-2/3d/stl/mast_lo_front.stl
106.8 x 56.0 x 23.5
