ms95ir-ctrl/Abadi_Rover/abadi-rover-2/3d/stl/tray_RR.stl

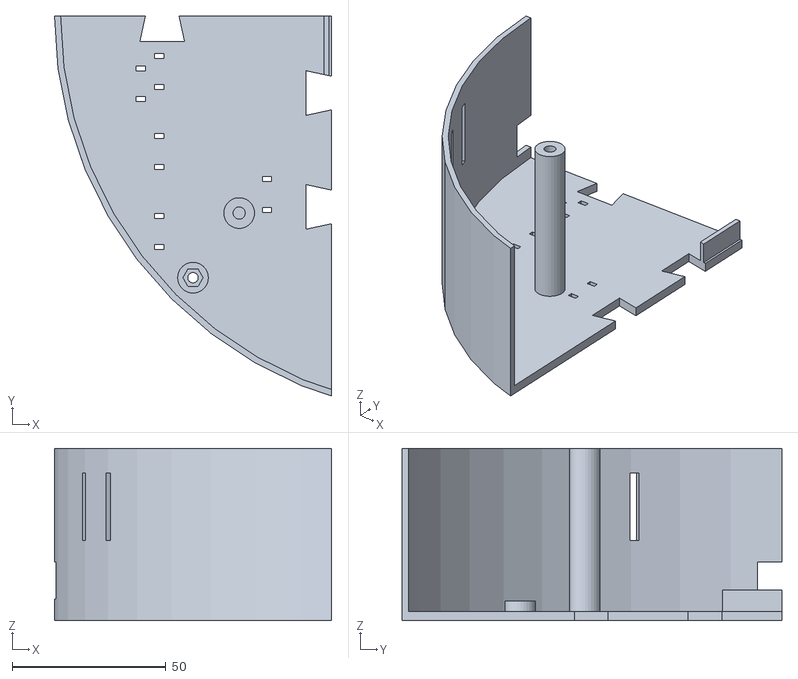
[picture p24: CAD file, 2026-11-05]
abadi-rover-2/3d/stl/tray_RR.stl
90.0 x 123.4 x 56.0
