ms95ir-ctrl/Abadi_Rover/abadi-rover-2/3d/stl/head_lid.stl

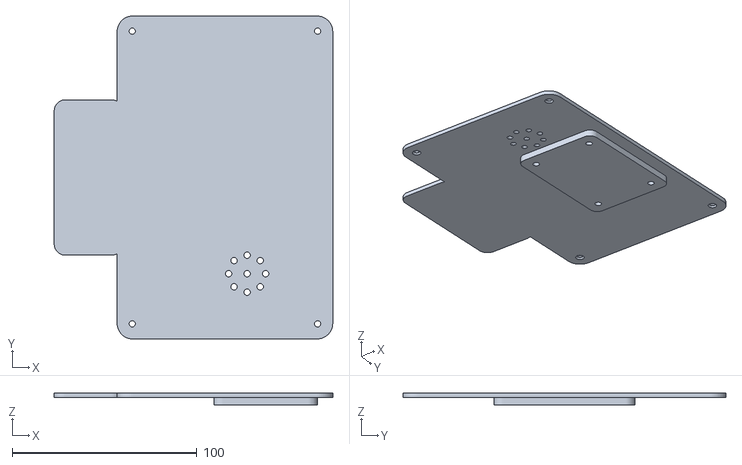
[picture p25: CAD file, 2026-11-05]
abadi-rover-2/3d/stl/head_lid.stl
150.6 x 174.6 x 6.40
