ms95ir-ctrl/Abadi_Rover/abadi-rover-2/3d/stl/mast_up_back.stl

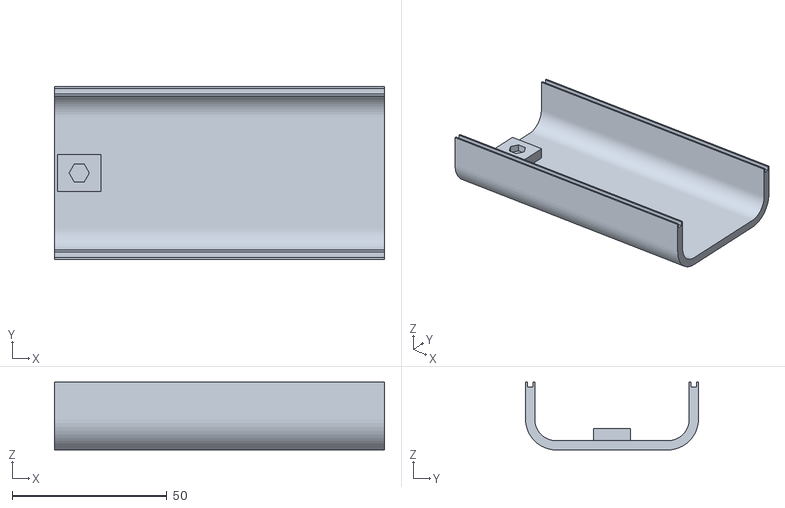
[picture p27: CAD file, 2026-11-05]
abadi-rover-2/3d/stl/mast_up_back.stl
106.8 x 56.0 x 22.0
