ms95ir-ctrl/Abadi_Rover/abadi-rover-2/3d/stl/bumper_C.stl

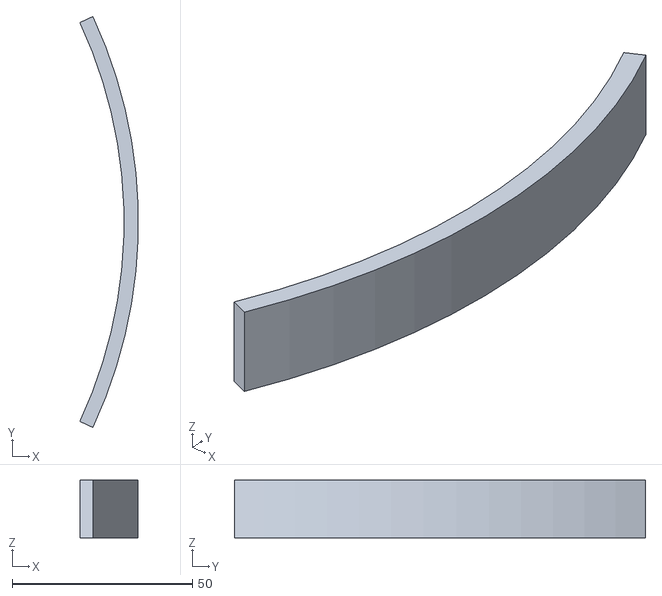
[picture p28: CAD file, 2026-11-05]
abadi-rover-2/3d/stl/bumper_C.stl
16.2 x 114.1 x 16.0
