ms95ir-ctrl/Abadi_Rover/abadi-rover-2/3d/stl/collar_front.stl

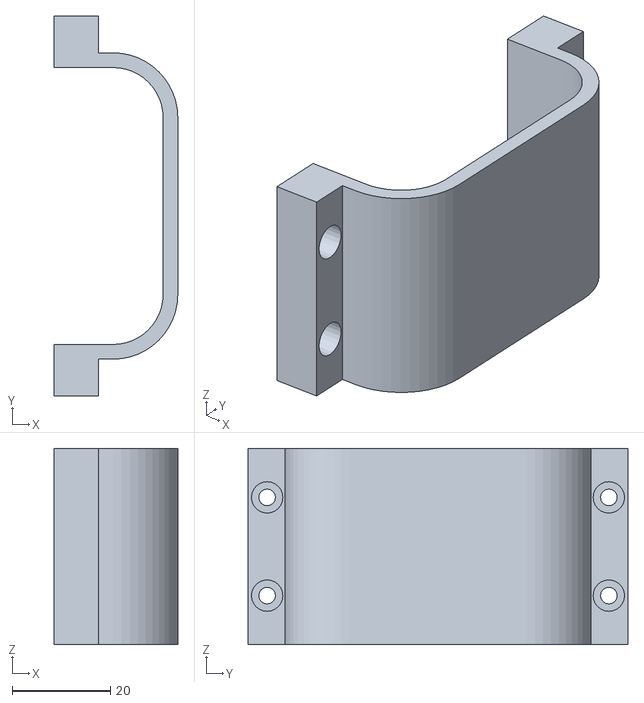
[picture p29: CAD file, 2026-11-05]
abadi-rover-2/3d/stl/collar_front.stl
25.2 x 77.4 x 40.0
