ms95ir-ctrl/Abadi_Rover/abadi-rover-2/3d/stl/caster_cup.stl

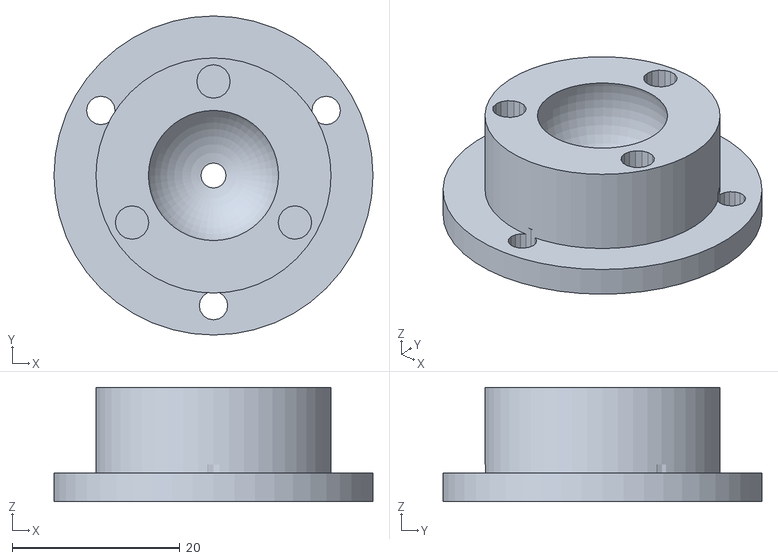
[picture p32: CAD file, 2026-11-05]
abadi-rover-2/3d/stl/caster_cup.stl
38.0 x 38.0 x 13.6
