ms95ir-ctrl/Abadi_Rover/abadi-rover-2/3d/stl/caster_ring.stl

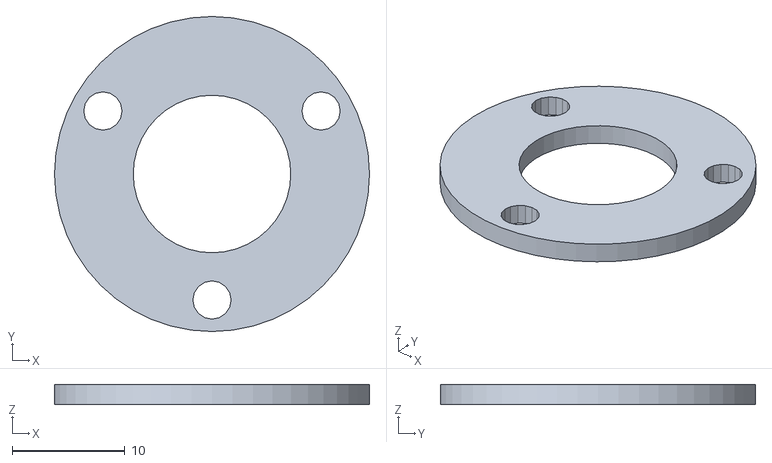
[picture p33: CAD file, 2026-11-05]
abadi-rover-2/3d/stl/caster_ring.stl
28.0 x 28.0 x 1.80
