ms95ir-ctrl/Abadi_Rover/abadi-rover-2/3d/stl/deck_RL.stl

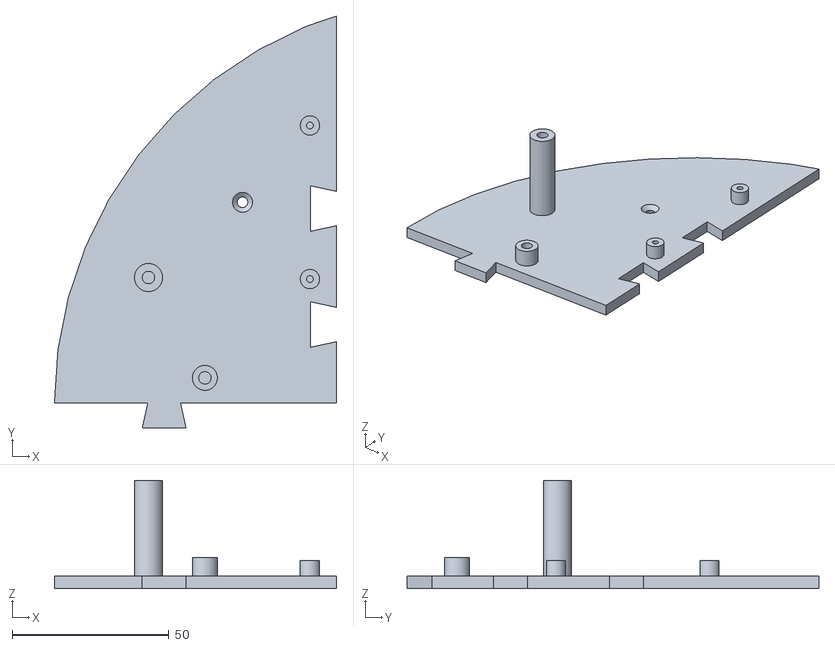
[picture p34: CAD file, 2026-11-05]
abadi-rover-2/3d/stl/deck_RL.stl
90.0 x 131.4 x 34.6
