ms95ir-ctrl/Abadi_Rover/abadi-rover-2/3d/stl/neck_plate.stl

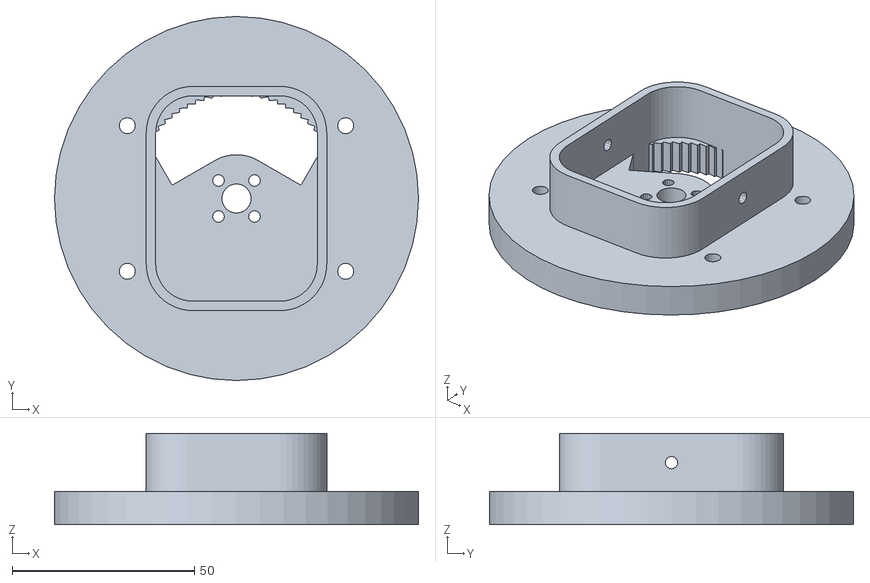
[picture p35: CAD file, 2026-11-05]
abadi-rover-2/3d/stl/neck_plate.stl
100.0 x 100.0 x 25.0
