ms95ir-ctrl/Abadi_Rover/abadi-rover-2/3d/stl/foot_plate.stl

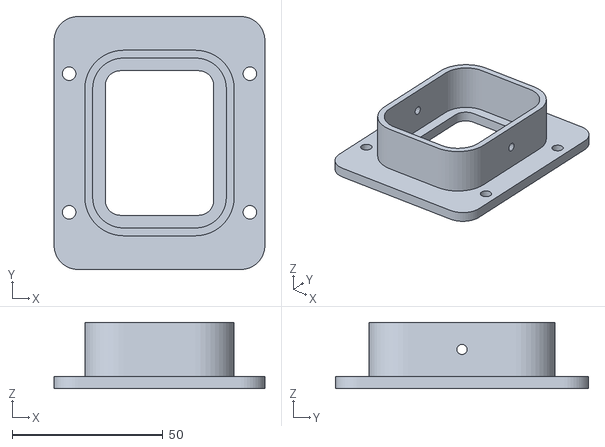
[picture p37: CAD file, 2026-11-05]
abadi-rover-2/3d/stl/foot_plate.stl
70.0 x 84.0 x 22.0
