ms95ir-ctrl/Abadi_Rover/abadi-rover-2/3d/stl/tray_FL.stl

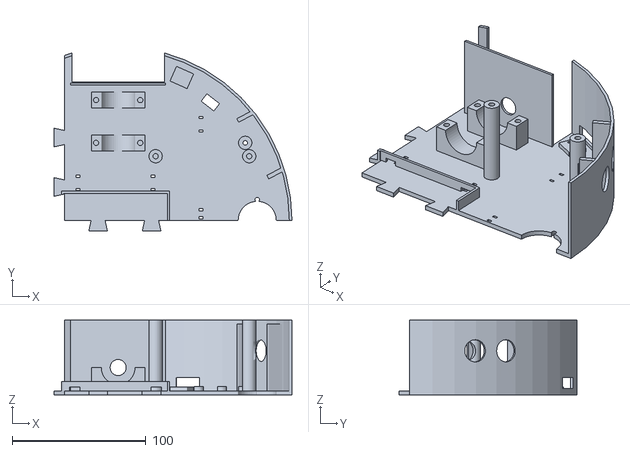
[picture p38: CAD file, 2026-11-05]
abadi-rover-2/3d/stl/tray_FL.stl
178.0 x 133.3 x 56.0
