ms95ir-ctrl/Abadi_Rover/abadi-rover-2/3d/stl/tray_FR.stl

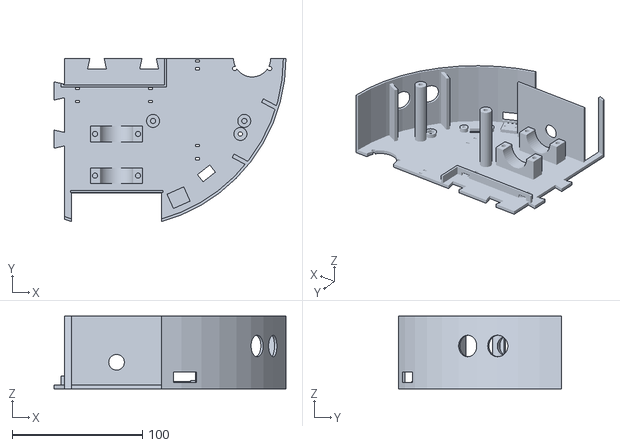
[picture p39: CAD file, 2026-11-05]
abadi-rover-2/3d/stl/tray_FR.stl
178.0 x 125.3 x 56.0
