ms95ir-ctrl/Abadi_Rover/abadi-rover-2/3d/stl/turntable.stl

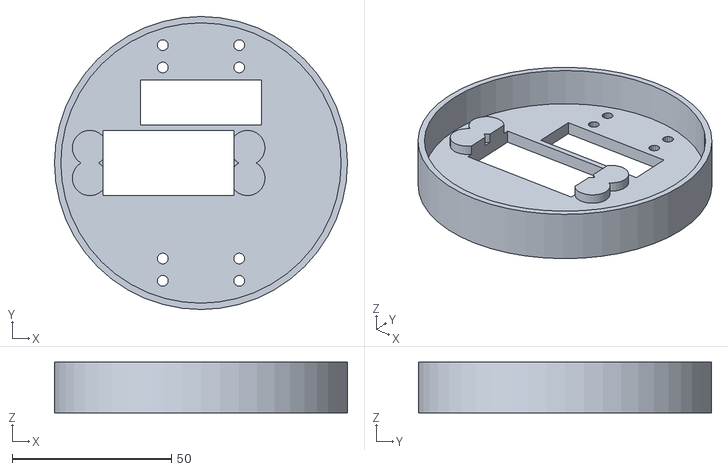
[picture p40: CAD file, 2026-11-05]
abadi-rover-2/3d/stl/turntable.stl
92.0 x 92.0 x 16.0
