ms95ir-ctrl/Abadi_Rover/abadi-rover-2/3d/stl/deck_FR.stl

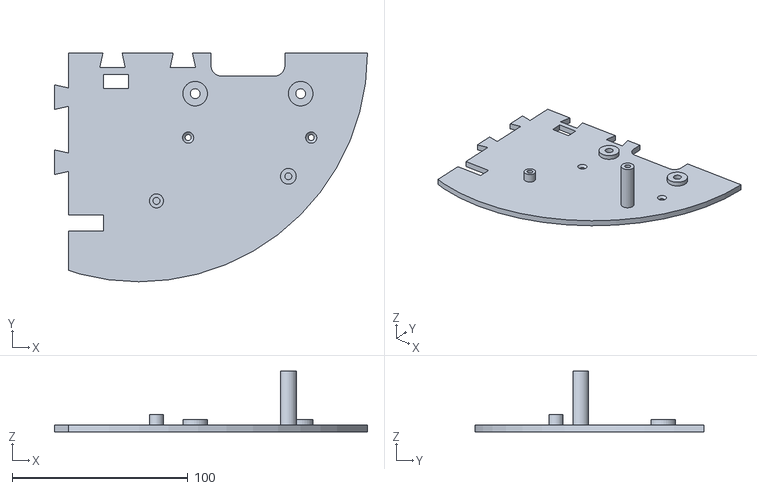
[picture p41: CAD file, 2026-11-05]
abadi-rover-2/3d/stl/deck_FR.stl
178.0 x 130.0 x 34.6
