ms95ir-ctrl/Abadi_Rover/abadi-rover-2/3d/stl/cover_FR.stl

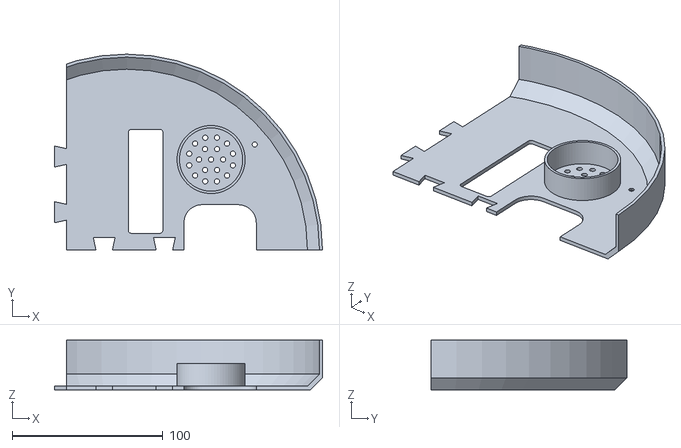
[picture p42: CAD file, 2026-11-05]
abadi-rover-2/3d/stl/cover_FR.stl
178.0 x 130.0 x 33.0
