ms95ir-ctrl/Abadi_Rover/abadi-rover-2/3d/stl/head_shell.stl

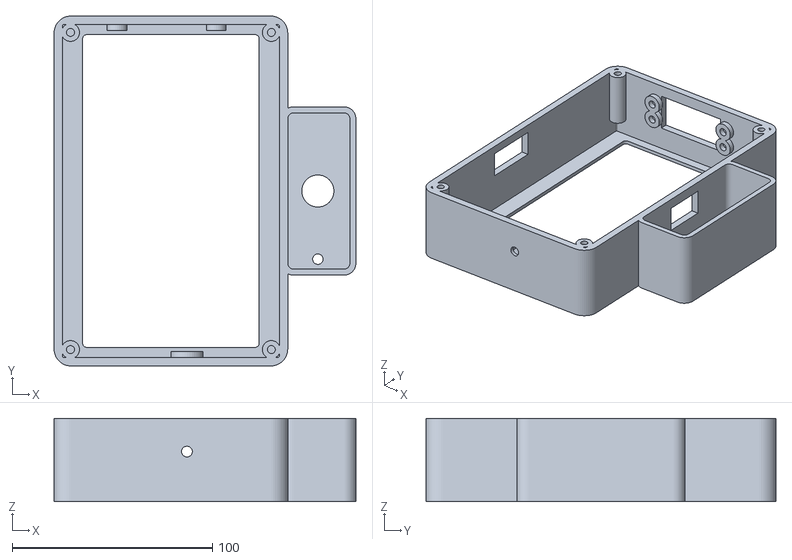
[picture p43: CAD file, 2026-11-05]
abadi-rover-2/3d/stl/head_shell.stl
150.6 x 174.6 x 41.6
