ms95ir-ctrl/Abadi_Rover/abadi-rover-2/3d/stl/plug_hood.stl

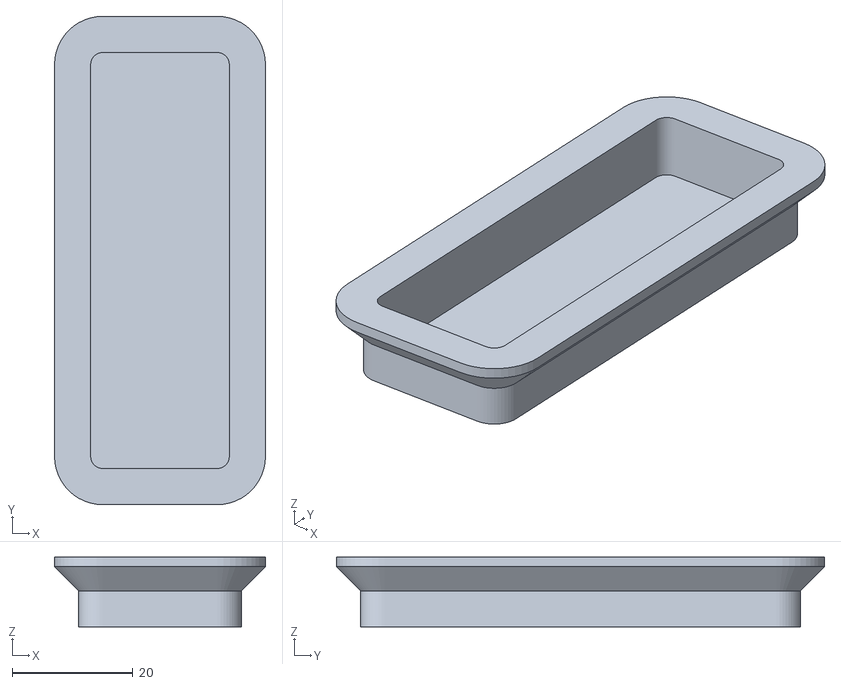
[picture p44: CAD file, 2026-11-05]
abadi-rover-2/3d/stl/plug_hood.stl
35.0 x 81.0 x 11.6
