ms95ir-ctrl/Abadi_Rover/abadi-rover-2/3d/stl/skid.stl

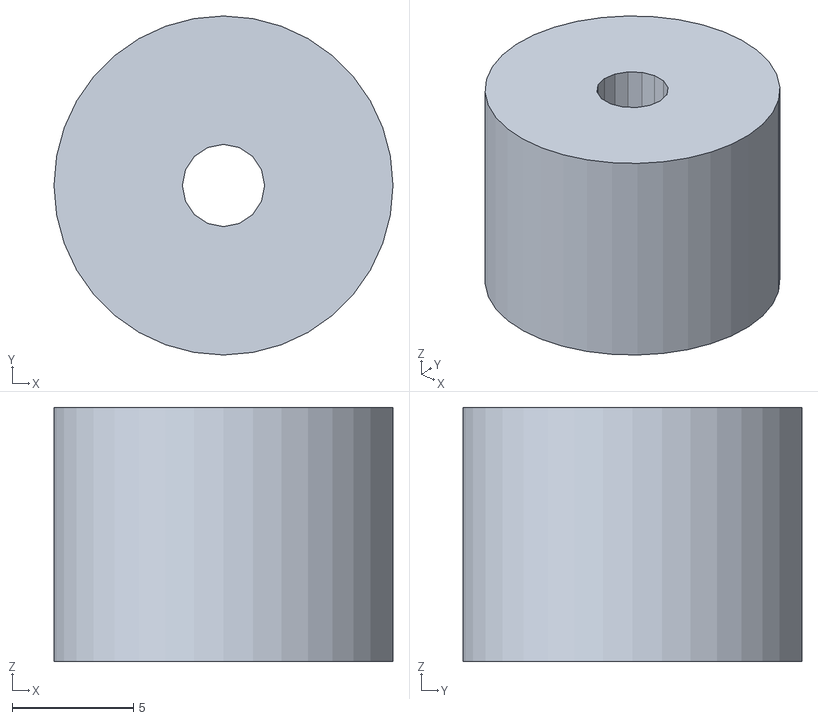
[picture p45: CAD file, 2026-11-05]
abadi-rover-2/3d/stl/skid.stl
14.0 x 14.0 x 10.5
