ms95ir-ctrl/Abadi_Rover/abadi-rover-2/3d/stl/deck_FL.stl

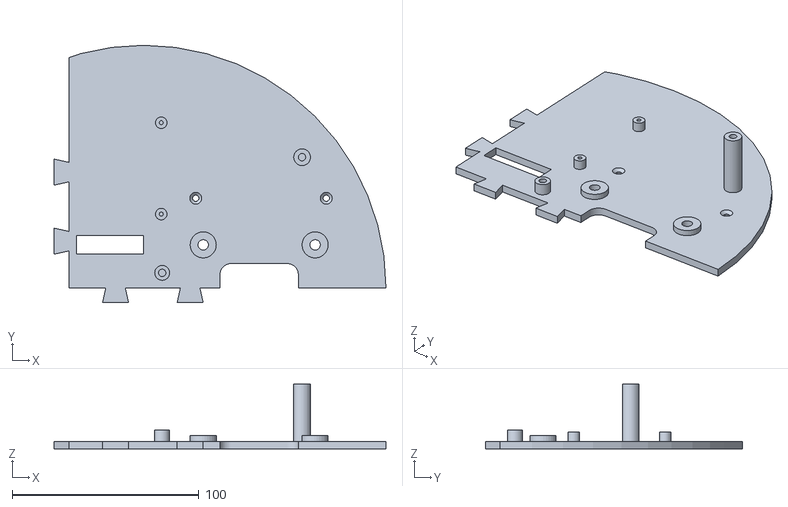
[picture p46: CAD file, 2026-11-05]
abadi-rover-2/3d/stl/deck_FL.stl
178.0 x 138.0 x 34.6
