ms95ir-ctrl/Abadi_Rover/abadi-rover-2/3d/stl/cam_cover.stl

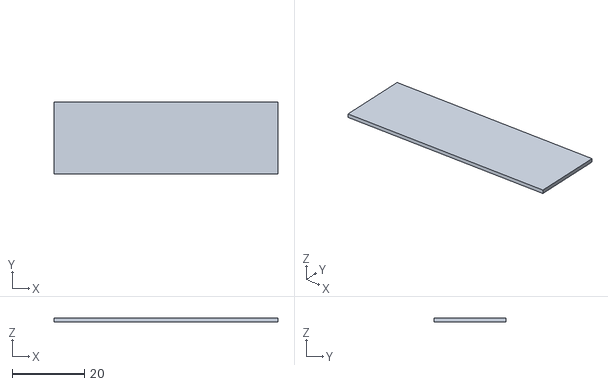
[picture p47: CAD file, 2026-11-05]
abadi-rover-2/3d/stl/cam_cover.stl
62.0 x 20.0 x 1.00
