ms95ir-ctrl/Abadi_Rover/abadi-rover-2/3d/stl/pivot_bush.stl

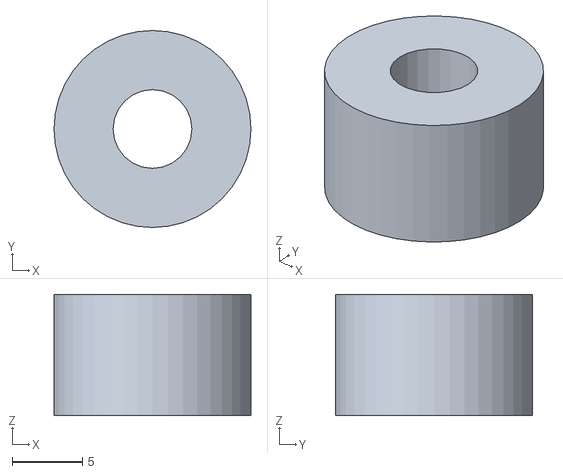
[picture p49: CAD file, 2026-11-05]
abadi-rover-2/3d/stl/pivot_bush.stl
14.0 x 14.0 x 8.60
