ms95ir-ctrl/Abadi_Rover/(list of files, cad)

Other CAD files:
abadi-rover-2/3d/stl/bumper_L.stl
abadi-rover-2/3d/stl/mast_lo_back.stl
abadi-rover-2/3d/stl/collar_back.stl
abadi-rover-2/3d/stl/yoke_servo_side.stl
abadi-rover-2/3d/stl/mast_up_front.stl
