ms95ir-ctrl/Abadi_Rover/abadi-rover-2/diagrams/wiring-robot2.png

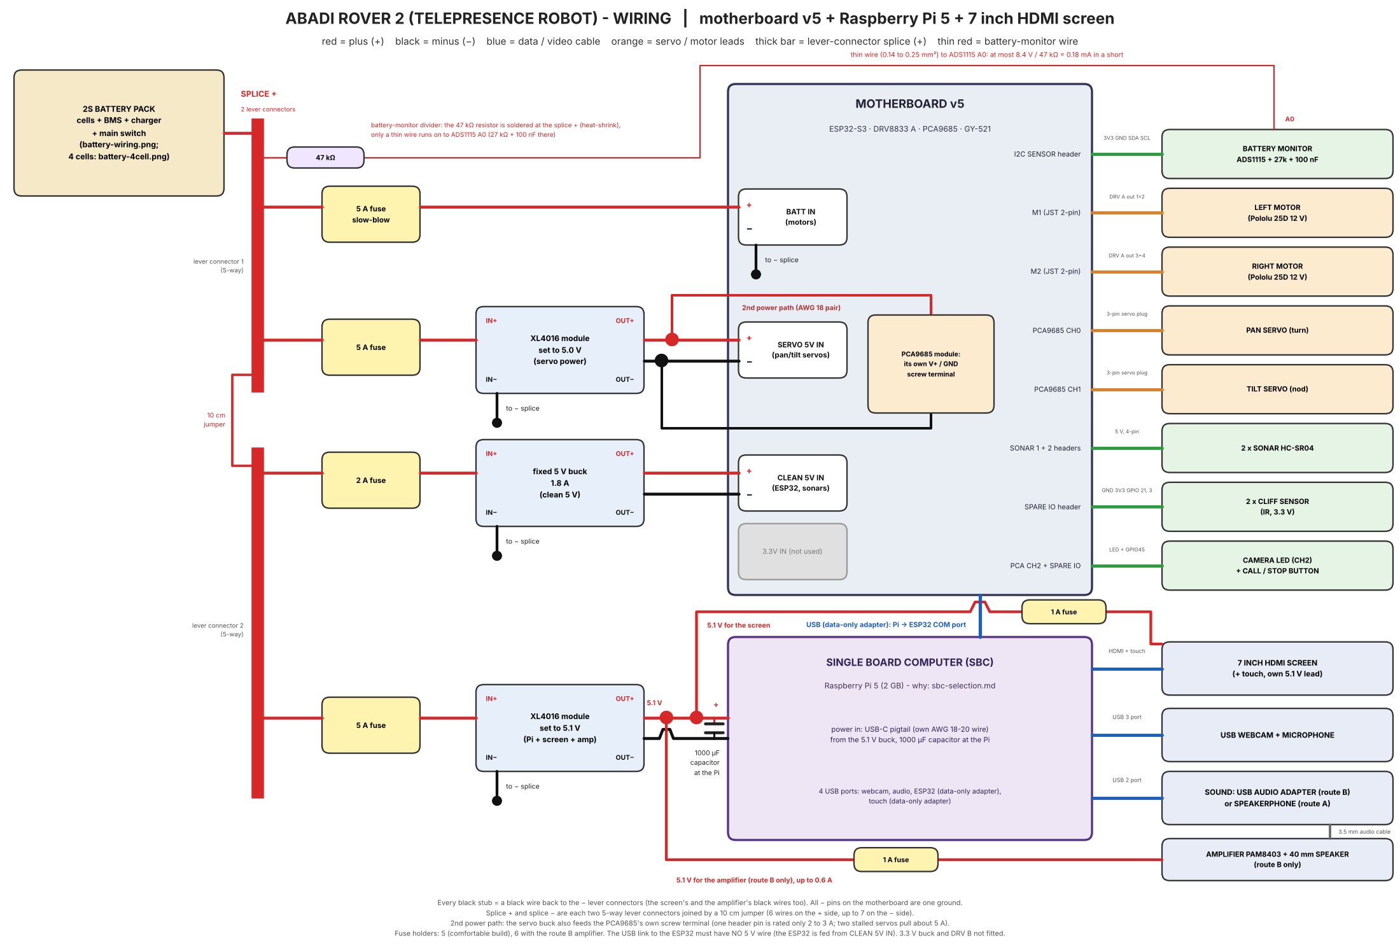
abadi-rover-2/diagrams/wiring-robot2.png
