ms95ir-ctrl/Abadi_Rover/pcb/kicad/battery-wiring.png

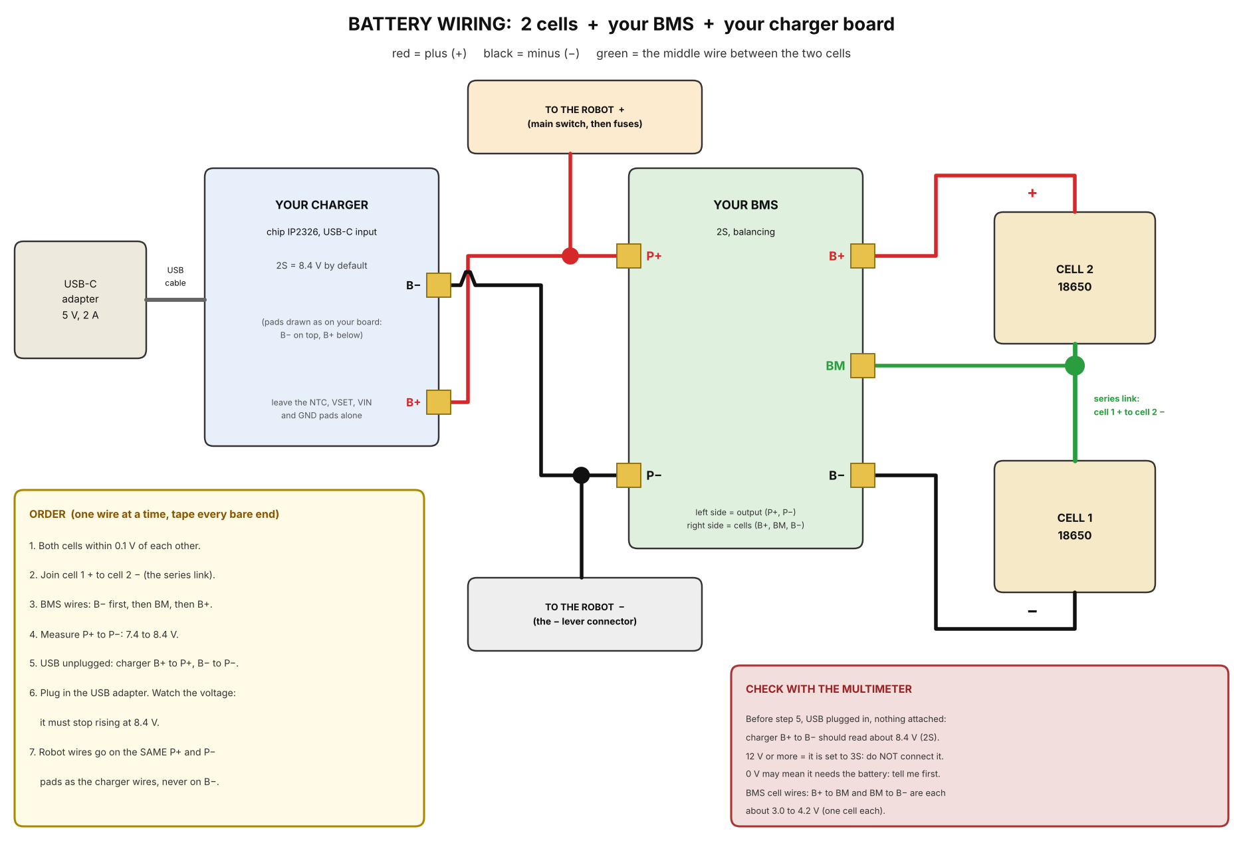
pcb/kicad/battery-wiring.png
