ms95ir-ctrl/Abadi_Rover/pcb/kicad/power-wiring.png

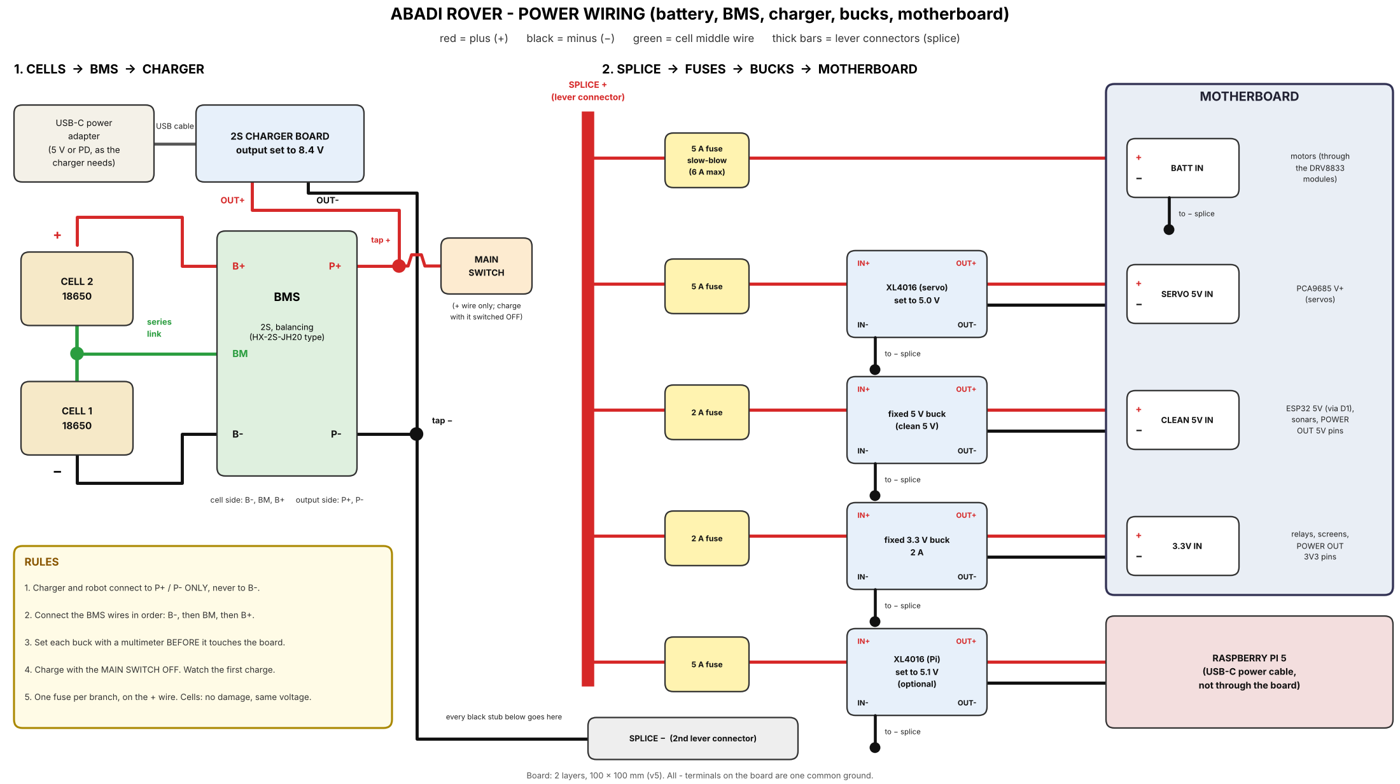
pcb/kicad/power-wiring.png
