ms95ir-ctrl/Abadi_Rover/relay-wiring.png

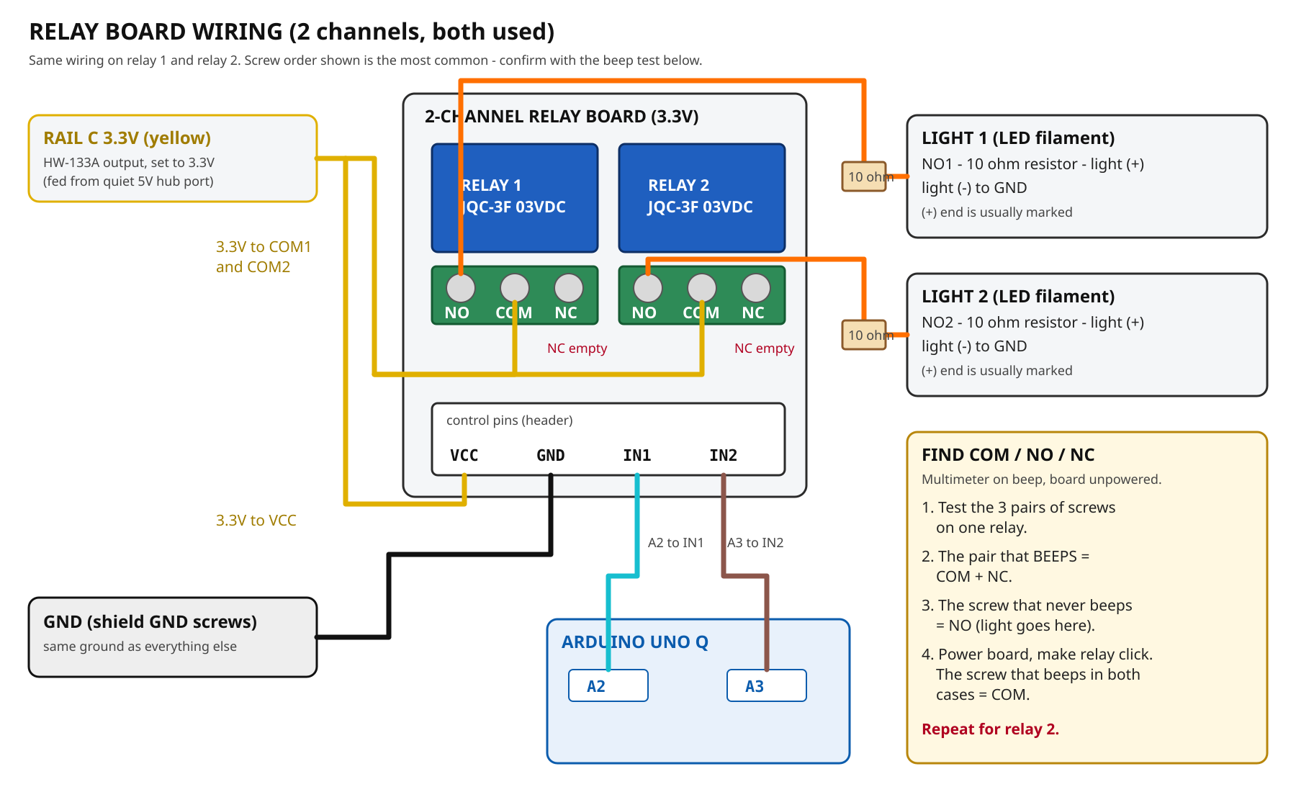
relay-wiring.png
