ms95ir-ctrl/Abadi_Rover/wiring-map-unoq.png

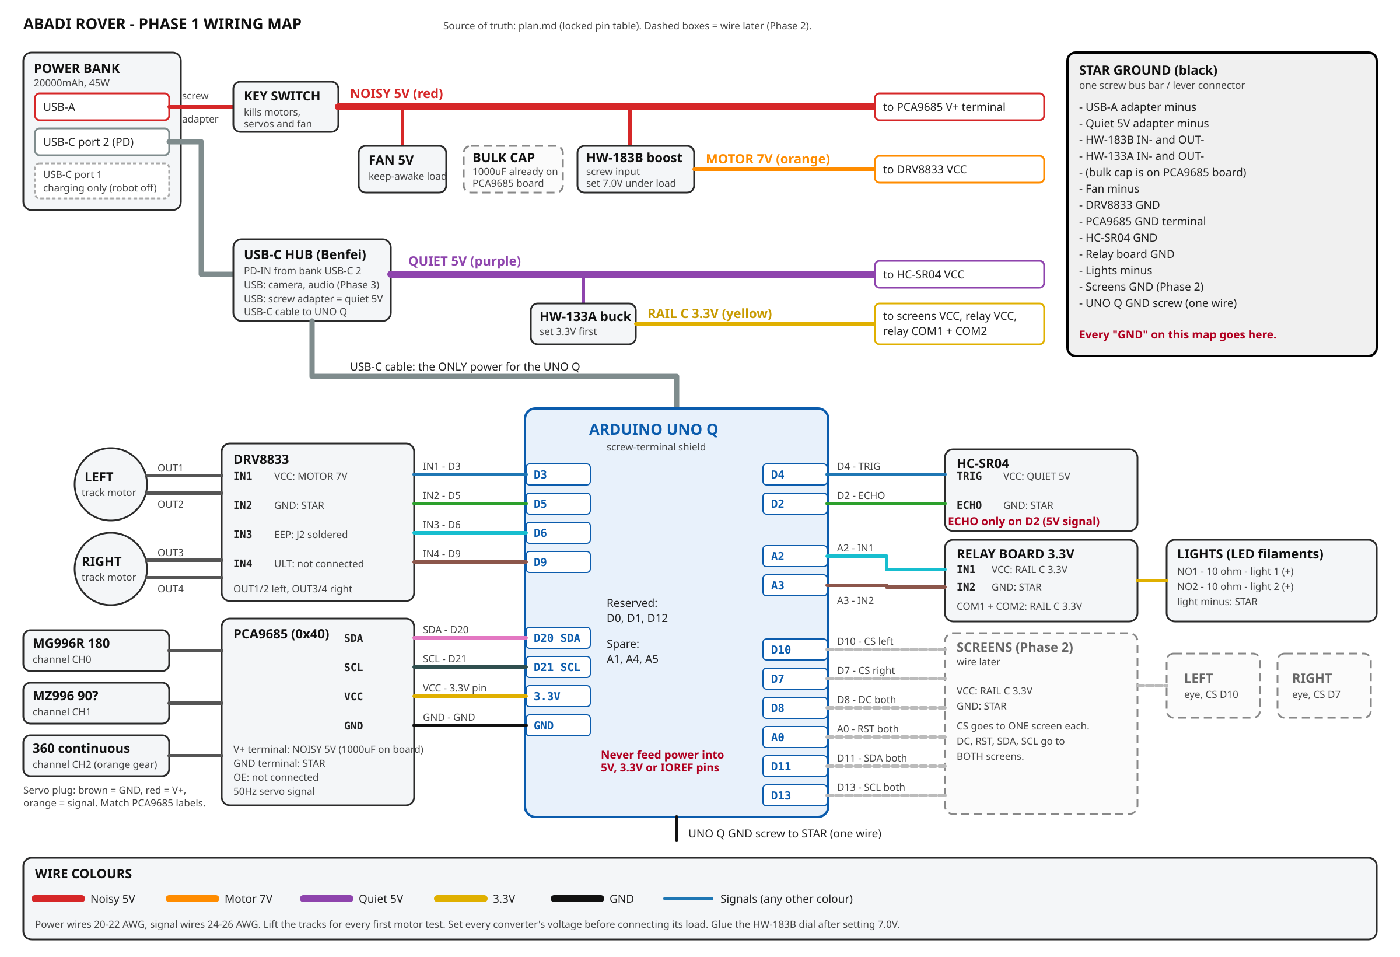
wiring-map-unoq.png
