ms95ir-ctrl/Abadi_Rover/pcb/kicad/fit-template-1to1.pdf

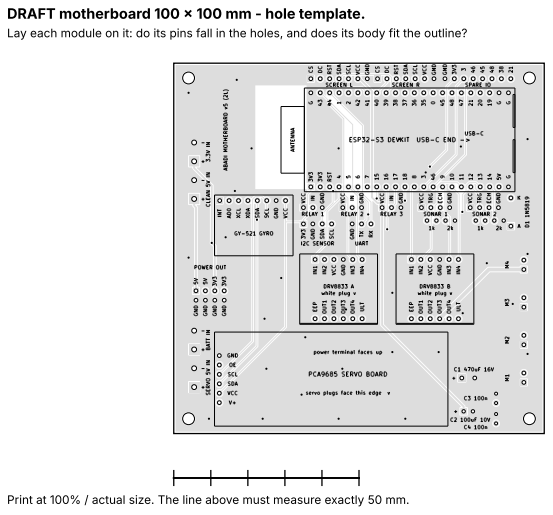
[picture p56: page 1]

DRAFT motherboard 100 x 100 mm - hole template.
Lay each module on it: do its pins fall in the holes, and does its body fit the outline?

Print at 100% / actual size. The line above must measure exactly 50 mm.
