ms95ir-ctrl/Abadi_Rover/pcb/kicad/abadi-motherboard.kicad_pcb

## KiCad design pcb/kicad/abadi-motherboard.kicad_pcb (2026-10-20)

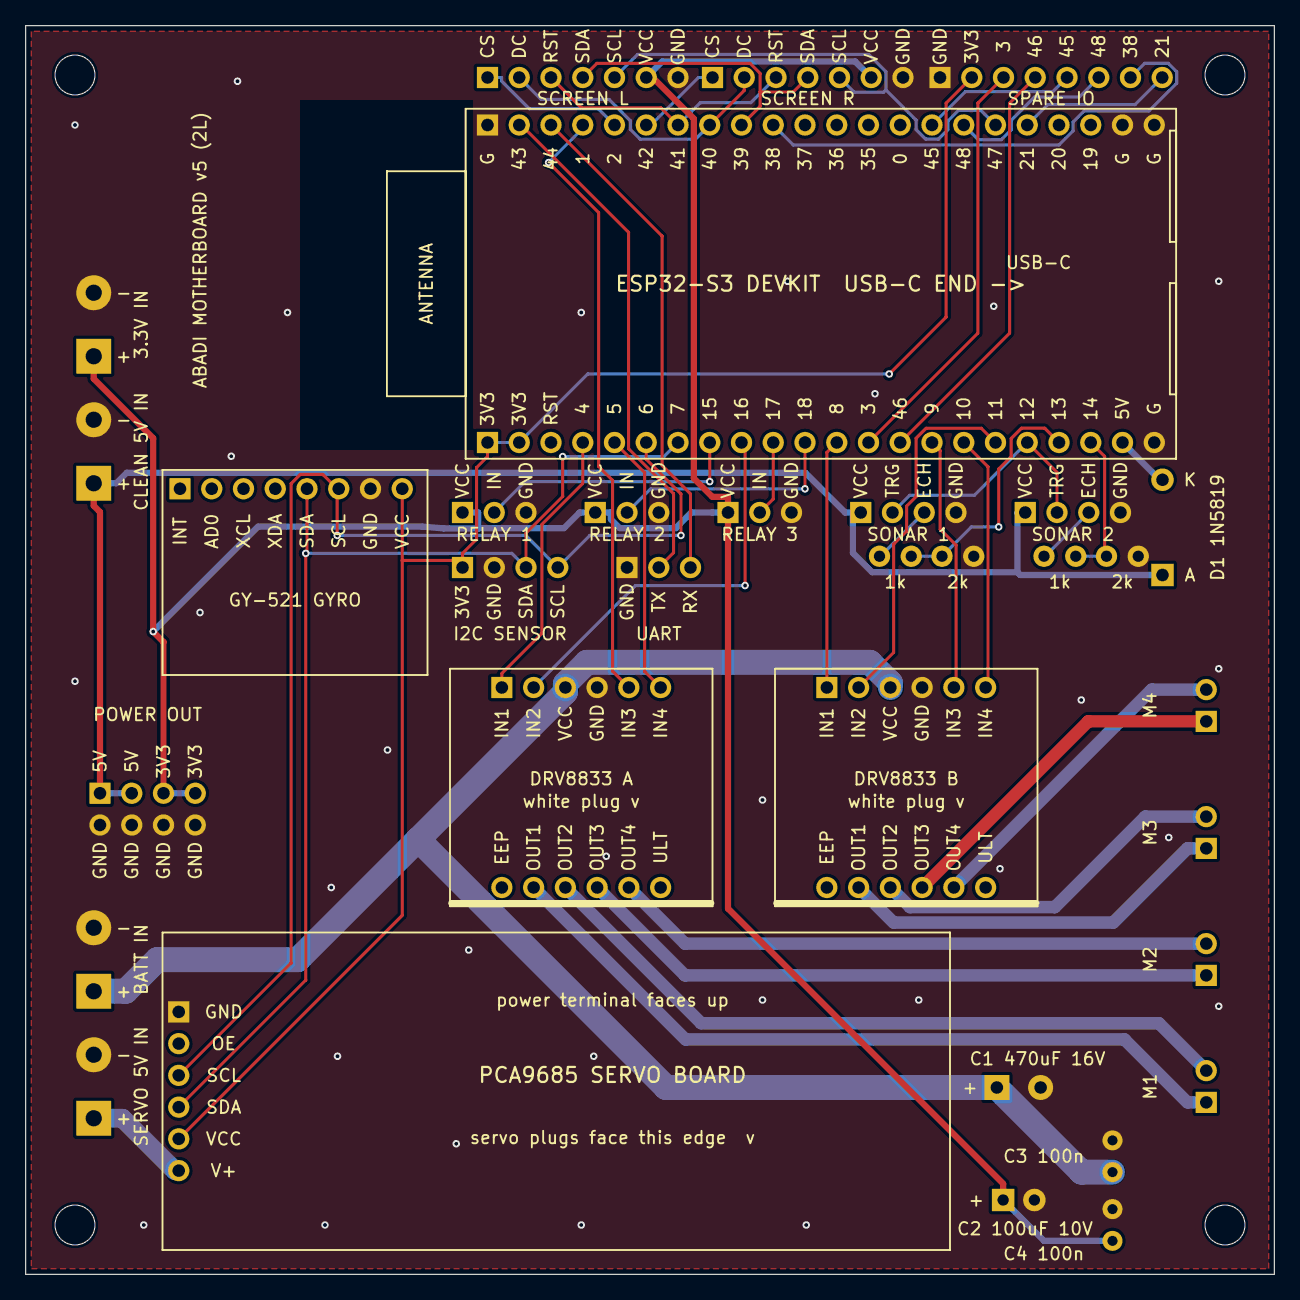
[picture p57: board abadi-motherboard.kicad_pcb from above]

Board: 2 copper layers, 99.9 x 99.9 mm, 38 parts (0 on the bottom side), 47 nets.

Parts:
C1: 470uF pack; FP_C1
C2: 100uF 3V3; FP_C2
C3: 100nF pack; FP_C3
C4: 100nF 3V3; FP_C4
D1: Schottky 1N5819; FP_D1
DRVA: DRV8833 A; FP_DRVA
DRVB: DRV8833 B; FP_DRVB
GYRO: GY-521 (INT AD0 XCL XDA SDA SCL GND VCC); FP_GYRO
H1, H2, H3, H4: MOUNT_M3
I2C: I2C SENSOR; FP_I2C
J1: ESP32-S3 row 1 (3V3 RST 4 5 ...); FP_J1
J3: ESP32-S3 row 2 (GND TX RX 1 2 ...); FP_J3
PCA: PCA9685 header (GND OE SCL SDA VCC V+); FP_PCA
PWR: POWER OUT (5V 5V 3V3 3V3 / GND x4); FP_PWR
RD1a: 1k; FP_RD1a
RD1b: 2k; FP_RD1b
RD2a: 1k; FP_RD2a
RD2b: 2k; FP_RD2b
RLY1H: RELAY 1; FP_RLY1H
RLY2H: RELAY 2; FP_RLY2H
RLY3H: RELAY 3; FP_RLY3H
SCR_L: SCREEN L; FP_SCR_L
SCR_R: SCREEN R; FP_SCR_R
SON1: SONAR 1; FP_SON1
SON2: SONAR 2; FP_SON2
SPARE: SPARE IO; FP_SPARE
TL0: SERVO 5V IN; FP_TL0
TL1: BATT IN; FP_TL1
TL2: CLEAN 5V IN; FP_TL2
TL3: 3.3V IN; FP_TL3
TM1: MOTOR 1 (2-pin JST); FP_TM1
TM2: MOTOR 2 (2-pin JST); FP_TM2
TM3: MOTOR 3 (2-pin JST); FP_TM3
TM4: MOTOR 4 (2-pin JST); FP_TM4
UART: UART; FP_UART

Connections:
CLEAN5: D1.1, PWR.1, PWR.2, SON1.1, SON2.1, TL2.1
CS_L: J3.5, SCR_L.1
CS_R: J3.6, SCR_R.1
ECHO1_3V: J1.19, RD1a.2, RD1b.1
ECHO1_5V: RD1a.1, SON1.3
ECHO2_3V: J1.20, RD2a.2, RD2b.1
ECHO2_5V: RD2a.1, SON2.3
ESP3V3: GYRO.8, I2C.1, J1.1, J1.2, PCA.5, SPARE.2
ESP5V: D1.2, J1.21
GND: C1.2, C2.2, C3.2, C4.2, DRVA.4, DRVB.4, GYRO.7, I2C.2, J1.22, J3.1, J3.21, J3.22, PCA.1, PWR.5, PWR.6, PWR.7, PWR.8, RD1b.2, RD2b.2, RLY1H.3, RLY2H.3, RLY3H.3, SCR_L.7, SCR_R.7, SON1.4, SON2.4, SPARE.1, TL0.2, TL1.2, TL2.2, TL3.2, UART.1
IN1A: DRVA.1, J1.4
IN1B: DRVB.1, J1.12
IN2A: DRVA.2, J1.9
IN2B: DRVB.2, J1.17
IN3A: DRVA.5, J3.4
IN3B: DRVB.5, J1.15
IN4A: DRVA.6, J1.5
IN4B: DRVB.6, J1.16
LCD_DC: J3.8, SCR_L.2, SCR_R.2
LCD_RST: J3.7, SCR_L.3, SCR_R.3
M1A: DRVA.8, TM1.1
M1B: DRVA.9, TM1.2
M2A: DRVA.10, TM2.1
M2B: DRVA.11, TM2.2
M3A: DRVB.8, TM3.1
M3B: DRVB.9, TM3.2
M4A: DRVB.10, TM4.1
M4B: DRVB.11, TM4.2
MOSI: J3.9, SCR_L.4, SCR_R.4
RAILC: C2.1, C4.1, PWR.3, PWR.4, RLY1H.1, RLY2H.1, RLY3H.1, SCR_L.6, SCR_R.6, TL3.1
RLY1: J1.8, RLY1H.2
RLY2: J1.11, RLY2H.2
RLY3: J1.10, RLY3H.2
SCK: J3.17, SCR_L.5, SCR_R.5
SCL: GYRO.6, I2C.4, J1.6, PCA.3
SDA: GYRO.5, I2C.3, J1.7, PCA.4
SERVO5: PCA.6, TL0.1
SPARE3: J1.13, SPARE.3
SPARE21: J3.18, SPARE.8
SPARE38: J3.10, SPARE.7
SPARE45: J3.15, SPARE.5
SPARE46: J1.14, SPARE.4
SPARE48: J3.16, SPARE.6
TRIG: J1.18, SON1.2, SON2.2
UART_RX: J3.3, UART.3
UART_TX: J3.2, UART.2
VBAT: C1.1, C3.1, DRVA.3, DRVB.3, TL1.1
