ms95ir-ctrl/Abadi_Rover/(commit log)

2026-10-12 Add locked build plan, wiring maps, and App Lab handover
2026-10-17 Add the PCB Gerber zip for a fabrication quote.
    The zip is the file a board house can price. It is a 2-layer body board from the reviewed draft, with labeled headers for the ESP32, two DRV8833 sockets, relays, servo board, and gyro.
    [abadi-B_Cu.gbl, abadi-B_Mask.gbs, abadi-B_Silkscreen.gbo, abadi-Edge_Cuts.gko, abadi-F_Cu.gtl, abadi-F_Mask.gts, abadi-F_Silkscreen.gto, abadi.drl]
2026-10-17 Shrink the rover PCB to 133 mm by 93 mm.
    The quote board was 224 mm by 218 mm, larger than the perfboard it replaces. The new Gerber keeps the same connectors and fits under 150 mm by 95 mm, with a to-scale layout picture.
    [abadi-B_Cu.gbl, abadi-B_Mask.gbs, abadi-Edge_Cuts.gko, abadi-F_Cu.gtl, abadi-F_Mask.gts, abadi-F_Silkscreen.gto, abadi.drl]
2026-10-17 Shrink the rover PCB to 105 mm by 84 mm on 4 layers.
    Inner 1 is a solid ground and inner 2 carries power, so the signal wires can cross. The quote file is still abadi-rover-body.zip.
    [abadi-B_Cu.gbl, abadi-B_Mask.gbs, abadi-Edge_Cuts.gko, abadi-F_Cu.gtl, abadi-F_Mask.gts, abadi-F_Silkscreen.gto, abadi.drl]
2026-10-18 Add draft v0 floor plan for a 100 x 100 mm reusable robot carrier board
    Placement-only pictures (top view and 3D-style view) plus the script that
    generates them and checks that no part overlaps, leaves the board, or sits
    on a mounting hole. Nothing is routed and nothing is for fabrication.
    Claude-Session: https://claude.ai/code/session_01FTMr77tNTaQwRQC74wgVC1
2026-10-18 Add draft v1 floor plan: 2S battery power, PCA9685 on board, 3 relays, 2 sonars, 2 touch inputs
    Placement-only pictures plus the generator and overlap check. Power now comes
    from a 2S pack input with three buck converters; charger and BMS stay off board.
    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
2026-10-18 Add routed 2-layer draft of the robot motherboard (KiCad board, Gerbers, checks)
    100 x 100 mm, 2 layers, fully routed with Freerouting. KiCad DRC shows 0 errors and
    0 unconnected pads; an independent check of the exported Gerber and drill files finds
    0 shorts and 0 opens. Module pin orders are standard-layout assumptions and still need
    a paper test-fit against the real parts, so this is a draft and not ready to order.
    Includes the build, routing and audit scripts, a 1:1 paper template, pin table and parts list.
    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
    [abadi-motherboard-B_Cu.gbl, abadi-motherboard-B_Mask.gbs, abadi-motherboard-B_Silkscreen.gbo, abadi-motherboard-Edge_Cuts.gm1, abadi-motherboard-F_Cu.gtl, abadi-motherboard-F_Mask.gts, abadi-motherboard-F_Silkscreen.gto, abadi-motherboard-NPTH.drl]
2026-10-19 Rebuild the robot motherboard as v3 from the paper test-fit
    Footprints now follow the measured ESP32-S3 board (57 x 28 mm, rows 25.4 mm
    apart), the PCA9685 header on its short end and the GY-521 pin order.
    Touch headers removed, all screw terminals 5.08 mm, 3-way power input for
    the bucks. Silkscreen now marks polarity and values (C1/C2, D1, resistors)
    and prints pin functions beside every cable header. Screen headers are
    2.54 mm apart and the antenna keep-out is larger.
    Fully routed on 2 layers. KiCad DRC shows 0 errors / 0 unconnected, and the
    independent Gerber audit finds 0 shorts / 0 opens (176 plated holes matched).
    The audit now also lists which pads sit in a split net.
    Co-Authored-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
    [abadi-motherboard-B_Cu.gbl, abadi-motherboard-B_Mask.gbs, abadi-motherboard-B_Silkscreen.gbo, abadi-motherboard-Edge_Cuts.gm1, abadi-motherboard-F_Cu.gtl, abadi-motherboard-F_Mask.gts, abadi-motherboard-F_Silkscreen.gto, abadi-motherboard-NPTH.drl]
2026-10-20 Motherboard v4: battery feeds the bucks outside the board, add POWER OUT header
    The three TO BUCK terminals are removed. The buck modules now take their
    battery power straight from the pack (off-board splice and fuse), and the
    board only has BATT IN (motors) plus the three buck outputs coming back in:
    SERVO 5V IN, CLEAN 5V IN and 3.3V IN.
    New POWER OUT header on the left edge: 2 x clean 5 V, 2 x 3.3 V (from the
    3.3 V buck, not the ESP32's own pin) and 4 x GND, each power pin with a
    ground pin below it. README gets a "How to wire the power" section.
    Routed on 2 layers: KiCad DRC 0 errors / 0 unconnected; independent Gerber
    audit 0 shorts / 0 opens (177 plated holes matched). Still a draft: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
    [abadi-motherboard-B_Cu.gbl, abadi-motherboard-B_Mask.gbs, abadi-motherboard-B_Silkscreen.gbo, abadi-motherboard-Edge_Cuts.gm1, abadi-motherboard-F_Cu.gtl, abadi-motherboard-F_Mask.gts, abadi-motherboard-F_Silkscreen.gto, abadi-motherboard-NPTH.drl]
2026-10-20 Motherboard v4: remove relay series resistors, loosen the header layout
    The relay modules are 3 V types with their own input circuit, so each relay
    header's IN pin now connects straight to its ESP32 pin (three resistors and
    their holes removed). The cable headers are spaced 3 mm apart, the I2C and
    UART headers moved up 2 mm, and diode D1 moved to the right of the sonar
    strip. The sonar echo dividers stay (ESP32-S3 pins are not 5 V tolerant).
    audit 0 shorts / 0 opens (177 plated holes matched).
    Claude-Session: https://claude.ai/code/session_01FTMr77tNTaQwRQC74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
    [abadi-motherboard-B_Cu.gbl, abadi-motherboard-B_Mask.gbs, abadi-motherboard-B_Silkscreen.gbo, abadi-motherboard-Edge_Cuts.gm1, abadi-motherboard-F_Cu.gtl, abadi-motherboard-F_Mask.gts, abadi-motherboard-F_Silkscreen.gto, abadi-motherboard-NPTH.drl]
2026-10-20 Motherboard v4: motor connectors become 2-pin JST spots, DRV pin names printed
    M1-M4 are now 2-pin positions on a 2.54 mm grid for the owner's 2-pin JST
    plugs instead of 5.08 mm screw terminals. The DRV8833 holes now print their
    pin names (IN1..IN4, GND, VM, motor outputs) so they can be compared with the
    module's own labels. Header spacing is 2.8 mm (a ground pad was walled in
    at 3.0 mm; the Gerber audit caught it).
    audit 0 shorts / 0 opens (172 plated holes matched).
    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
    [abadi-motherboard-B_Cu.gbl, abadi-motherboard-B_Mask.gbs, abadi-motherboard-B_Silkscreen.gbo, abadi-motherboard-Edge_Cuts.gm1, abadi-motherboard-F_Cu.gtl, abadi-motherboard-F_Mask.gts, abadi-motherboard-F_Silkscreen.gto, abadi-motherboard-NPTH.drl]
2026-10-20 Motherboard v5: DRV8833 two rows of 6 holes, screen pin order, ratings, stitching vias
    DRV8833 (HW-627) footprints now follow the owner's reading of the module: top
    row IN1 IN2 VCC GND IN3 IN4 (VCC = battery), bottom row (white plug side) EEP
    OUT1 OUT2 OUT3 OUT4 ULT, with the pin names printed. Screen headers follow the
    screens' own order CS DC RST SDA SCL VCC GND. Capacitor ratings are printed on
    the board and listed in the parts list, which now says what to buy for every
    footprint. Outline trimmed so the Gerber extents are exactly 100.0 x 100.0 mm.
    30 ground stitching vias tie the two ground pours together. New shopping list
    (including off-board power parts and first power-up steps); READM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
    [abadi-motherboard-B_Cu.gbl, abadi-motherboard-B_Mask.gbs, abadi-motherboard-B_Silkscreen.gbo, abadi-motherboard-Edge_Cuts.gm1, abadi-motherboard-F_Cu.gtl, abadi-motherboard-F_Mask.gts, abadi-motherboard-F_Silkscreen.gto, abadi-motherboard-NPTH.drl]
2026-10-20 Motherboard v5: act on the independent review (DRV marks, slit fix, docs)
    A thick silkscreen bar marks the plug side of both DRV8833 outlines, the top
    header labels move 0.12 mm away from the board edge and the module labels
    0.12 mm away from the ESP32 outline. A 0.03 mm copper slit beside RLY1H pad 1
    is removed with a short dogleg in the RAILC trunk; the Gerber audit now also
    checks for slits inside one copper piece. Documents corrected: fuse sizes per
    branch (BATT IN 5 A slow-blow), POWER OUT about 1 A usable, DRV reading
    direction and the checks to do on the real module, UART console note, buck input
    range checks, pin-table motor mapping, 99.9 mm cut size.
    Routed on 2 layers: KiCad DRC 0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
    [abadi-motherboard-B_Cu.gbl, abadi-motherboard-B_Mask.gbs, abadi-motherboard-B_Silkscreen.gbo, abadi-motherboard-Edge_Cuts.gm1, abadi-motherboard-F_Cu.gtl, abadi-motherboard-F_Mask.gts, abadi-motherboard-F_Silkscreen.gto, abadi-motherboard-NPTH.drl]
2026-10-30 Add a power wiring diagram (cells, BMS, charger, splice, fuses, bucks, board)
    One picture of the whole power system: 2S cells to the BMS (B-, BM, B+), the
    charger and the robot sharing the BMS output (P+, P-), the main switch on the
    plus wire, the lever-connector splice, one fuse per branch, the three bucks
    (and the optional Raspberry Pi buck) and the four motherboard power terminals.
    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
2026-10-30 Add a battery-only wiring diagram for the owner's BMS and IP2326 charger
    Drawn from the owner's photo: BMS pads P+ P- (output) and B+ BM B- (cells),
    charger chip IP2326 with USB-C input and B+ / B- battery pads. Shows the
    order of work and the multimeter checks before the first charge.
    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
2026-11-05 Start robot 2 (telepresence robot): brief and first wiring diagram
    Adds the brief (the owner's request and the fixed facts about the motherboard
    and power system) that the design helpers work from, and a first wiring diagram
    for the telepresence robot: motherboard v5 + single board computer + HDMI screen,
    with the drawing script so it can be regenerated.
    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
    [draw_wiring.py]
2026-11-05 Add Abadi Rover 2 (telepresence robot) as its own folder; root README as an index
    - Rename the robot 2 working folder telepresence/ to abadi-rover-2/ (robot 1 files stay untouched at the top level).
    - Design draft from five specialist passes: SBC choice, software plan and ESP32 serial protocol,
    mechanical design with OpenSCAD files, STL parts and pictures, peripherals, parts list (CSV and markdown).
    - New: functions list, final wiring document (decisions on the helpers' conflicts), updated wiring diagram,
    robot 2 README with decisions, build stages and open questions.
    - Root README now indexes Abadi Rover 1, Abadi Rover 2 and the shared motherboard.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
    [assembly.scad, base.scad, bumper_C.stl, bumper_L.stl, bumper_R.stl, caster_cup.stl, caster_ring.stl, collar_back.stl]
2026-11-05 Robot 2: README stage rules, runtime and cable limits, family STOP wording, board-version question
    Part of the review-fix pass; the other docs and the CAD are still being updated.
    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
2026-11-05 Robot 2: apply the independent review (wiring, protocol, software plan, parts, CAD, pictures)
    Review-fix pass 1: binding decisions applied across the docs (tilt guard 10 degrees,
    motor cap 8 V, USB cable bench tests, runtime 1.1-1.4 h, stage rules, 2S2P option,
    second servo power path, divider at the splice, amplifier fuse), CAD fixes (skid gap,
    posts, cover relief, cliff text, bumper, button/LED/cover/speaker places), all STL and
    pictures re-exported, calculation scripts added in 3d/tools.
    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
    [assembly.scad, base.scad, bumper_C.stl, bumper_L.stl, bumper_R.stl, cam_cover.stl, caster_cup.stl, caster_ring.stl]
2026-11-05 Robot 2: second review pass (cross-file consistency: wiring, parts, protocol, software plan, mechanical text, CAD tools, pictures)
    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
    [parts-list.csv]
2026-11-05 Robot 2: last review pass (stale weights, assembly order, mast stiffness numbers, front picture, parts wording, 4-cell picture)
    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
    [pan_tilt_interface.scad, parts-list.csv, robot2_params.scad]
2026-11-05 Robot 1: draft of the new plan.md for the motherboard (not applied; plan.md and wiring.md unchanged)
    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
